Abyaneh/Control-of-Ball-Position-on-a-Horizontal-Rod/Report.pdf

### In the Name of God

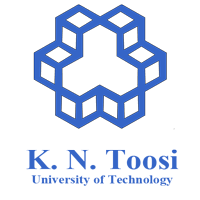
[picture p2: figure]

## Control of Ball Position on a Horizontal Rod

Table of Contents:

1. Introduction | 4
2. Modeling, Theoretical Review, and Dynamic Analysis | 5
3. Introduction of Components | 8
3.1 AC Servo Motor (Delta Asda A2) | 8
3.2 Servo Motor Driver (ASD-A2-0721-M) | 9
3.3 STM32 Microcontroller Board (F407ZET6) | 10
3.4 Planetary Gearbox (C002F0420MT10) | 10
3.5 Ultrasonic Distance Sensor (SRF05) | 11
3.6 Encoder | 12
3.7Interface Board | 12
3.8 Power Supply and Fuse | 13
3.9 Voltage Regulator (Lm2596) | 14
3.10 ST-LINK/V2 Programmer | 14
3.11 Magnetic Limit Switches | 15
3.12 Final Assembly of the System | 15
4. System Specifications | 16
5. STM32 Pin Descriptions | 16
5.1 Important Pin Functions (TRIG, ECHO, Pulse, Direction,
USART) | 16
5.2 General Configuration of Pins | 18
6. STM32 Code Logic | 19
6.1 Library Initialization | 19
6.2 Sensor and Motor Control Setup | 19
6.3 PID Controller Setup | 20
6.4 Loop Structure and Sensor Feedback | 20
6.5 While Loop and Motor Control | 20
6.6 Ultrasonic Sensor Data Reading | 21
7. MATLAB Code | 22

### 1. Introduction:

One of the most fascinating and relatively simple examples of mechanical engineering and control systems is the ball and rod system. The overall function of this system is to control and maintain a ball on a horizontal rod, which is connected to a motor and specific supports. The system should be able to keep the ball in position, even if an external disturbance affects the ball.

The position of the ball is determined by sensors, which will be explained in more detail later. Using these sensors, the motor generates the necessary torque to rotate the rod and maintain the ball's balance. Any potential errors detected by the sensors are sent to the controller, which then sends appropriate commands to the motor.

### 2. Modeling, Theoretical Review, and Dynamic Analysis:

The ball and rod system can be examined in two main configurations:

1. The motor is positioned at the center of the rod.
2. The motor is located at the end of the rod and connected by a lever.

A schematic of these two types is shown in Figure 1.

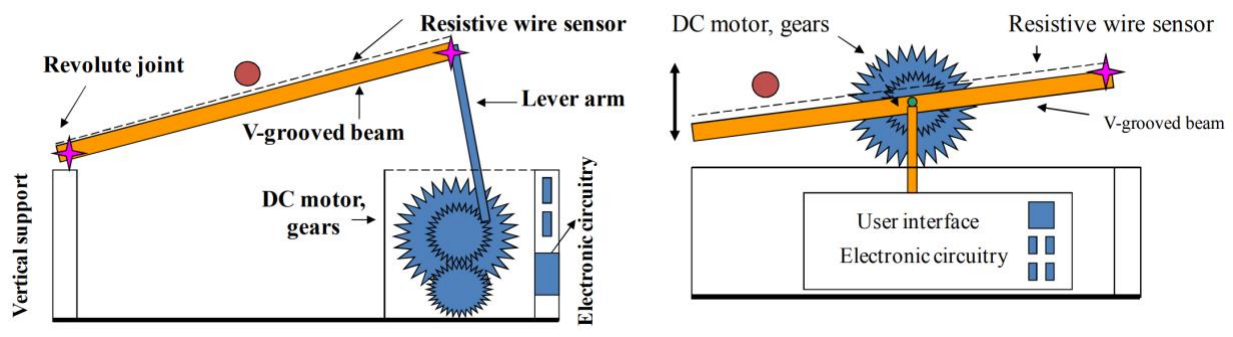
[picture p3: figure]

Our project is based on the right-side configuration, where the motor is located at the center of the rod. This system can be solved using both Newtonian and Lagrangian methods (related to energy). For the Newtonian method, we first draw a free-body diagram for the system as shown in Figure 2.

A schematic of these two types is shown in Figure 1.

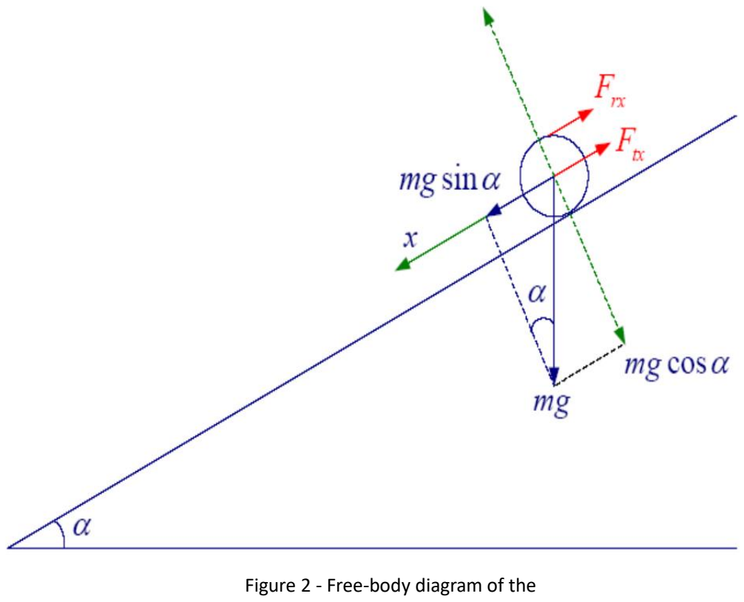
[picture p4: figure]
Figure 2 - Free-body diagram of the

The forces created by translational motion along the rod and the acceleration generated in this direction are represented by Ftx, and the forces created by rotational motion are represented by Frx. This rotational force itself creates a twisting torque around the ball, which is calculated by multiplying Frx by the radius of the ball. Additionally, we know that the sum of the torques is equal to the moment of inertia of the object times the angular acceleration.

The result of all these forces and torques can be expressed by the following equations:

Ftx = mẍ

Tr = FrxR = Jω̇

ω =

v
R

→ Tr =

J
R

ẍ → Frx =

J
R²

ẍ

In these equations:

- m is the mass of the ball,
- J is the moment of inertia of the ball,
- x is the position of the ball on the rod,
- TrTr is the rotational torque of the ball,
- R is the radius of the ball.

Furthermore, the sum of the forces can be expressed as:

Frx + Ftx = mg sin α

Next, using the energy method, we know that the total energy of the system is the sum of the energy of the rod and the ball:

T = Tbeam + Tcylinder

Tbeam =

1
2

Ibθ̇
b

2

For the ball, which is modeled as a cylinder, the kinetic energy is given by:

Tcylinder =

1
2

mcṙc

2 +

1
2

Icθ̇
c

2

Ic =

1
2

mcR

2

where rc is the position of the ball on the rod and R is the radius of the circular cross-section of the cylindrical ball.
ṙc = Rθ̇
c
Therefore, the total kinetic energy of the system can be expressed as follows:

T =

1
2

Ibθ̇
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
Ibθ̇
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
Ibθ̇
b

2 +

3
4

mcṙc

2

Now, provided that the angle the rod makes with the horizontal is θb, we will also have for the potential energy of the system:
U = mcg. (rc sin θb)

It should be noted that the reference point for potential energy is the horizontal line passing through the center of mass of the rod, or the point of attachment of the motor, and for this reason, the potential energy of the rod remains unchanged, and the equation only includes the term related to the ball.

Now, we will derive the expression for the Lagrangian, which is the result of the difference between kinetic and potential energy:

L =

1
2

Ibθ̇
b

2 +

3
4

mcṙc

2 − mcg. (rc sin θb)

L(q, q̇) = T(q, q̇) − U(q) d
dt[

∂L
∂q̇
i

] −

∂L
∂qi

= Fqi

Now, in this system, we have two types of motion and consequently two generalized coordinates, which are θb and rc. Instead of Fqi, we will have the torque generated by the motor, which we denote as τ:
∂L
∂θb

= −mcgrc cos θb

∂L
∂rc

=

3
2

mcṙc

∂L
∂θ̇
b

= Ibθ̇
b →

d

dt[
∂L
∂θ̇
b

] = Ibθ̈
b

∂L
∂ṙc

=

3
2

mcṙc →

d
dt [

∂L
∂ṙc

] =

3
2

mcr̈c

On the other hand, the equations with respect to θb correspond to the torque of the system, and with respect to rc relate to the resultant force applied, which will result in:

Ibθ̈
b + mcgrc cos θb = τ
3
2

mcr̈c −

3
2

mcṙc = 0

Now, we can find the transfer function using one of the two methods discussed above. For example, based on the derived equation, we can take the Laplace transform, and if we set the initial conditions to zero, we will have:
J
R²

s

2X(s) + ms

2X(s) = mg. α(s)

G(s) =

X(s)
α(s)

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
For this system, we will have g=9.81 .m
s

2

, m=50.7 g, R=2 cm, and
J=0.5 mR²
, which results in the value of the transfer function being equal to:
J = 1.014 ∗ 10⁻⁵

[kg. m²
]

G(s) =

6.54
s

2

[

m
rad]

It should be noted that the angle of the rod is considered as the input, and the position of the ball is considered as the output.

### 3. Introduction of Components:

### 3.1 AC Servo Motor, Model Delta Asda A2:

- This model of servo motor is used as the system’s driving force.
- Inputs: VAC110 and 5.1A, Output: 0.75KW
- Maximum Output Speed: 3000rpm, Maximum Torque: 2.39N.m

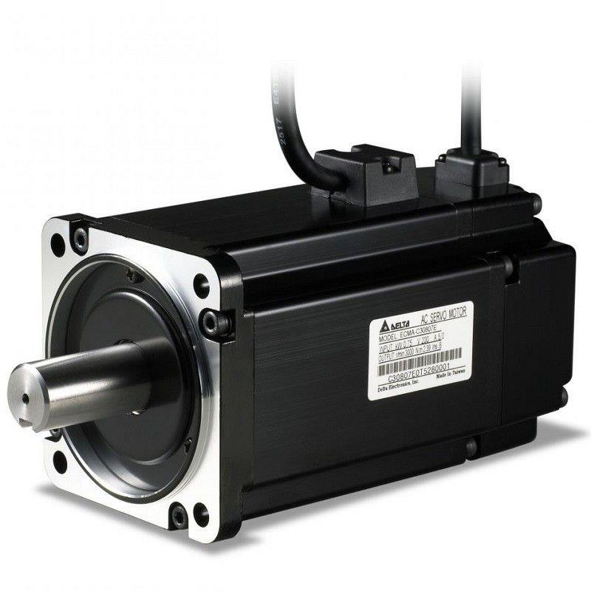
[picture p5: figure]

Figure 3 - AC Servo Motor, Model Delta Asda A2

### 3.2 Servo Motor Driver, ASD-A2-0721-M:

- The STM32 board sends commands to the driver, which adjusts the motor's position and applies the correct voltage.
- Input: 200-230V, Output: 110V, 5.1A

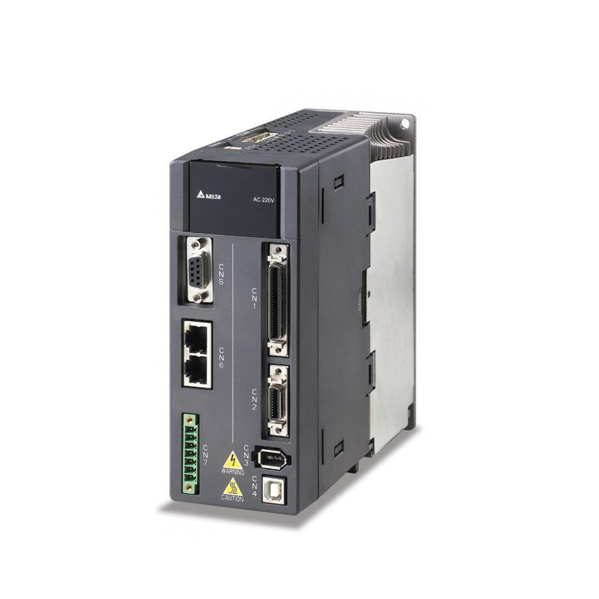
[picture p6: figure]

Figure 4 - Servo Motor Driver, ASD-A2-0721-M

### 3.3 STM32 Board, Model F407ZET6:

- This board controls the system and sends signals to the motor driver to adjust the motor’s position.

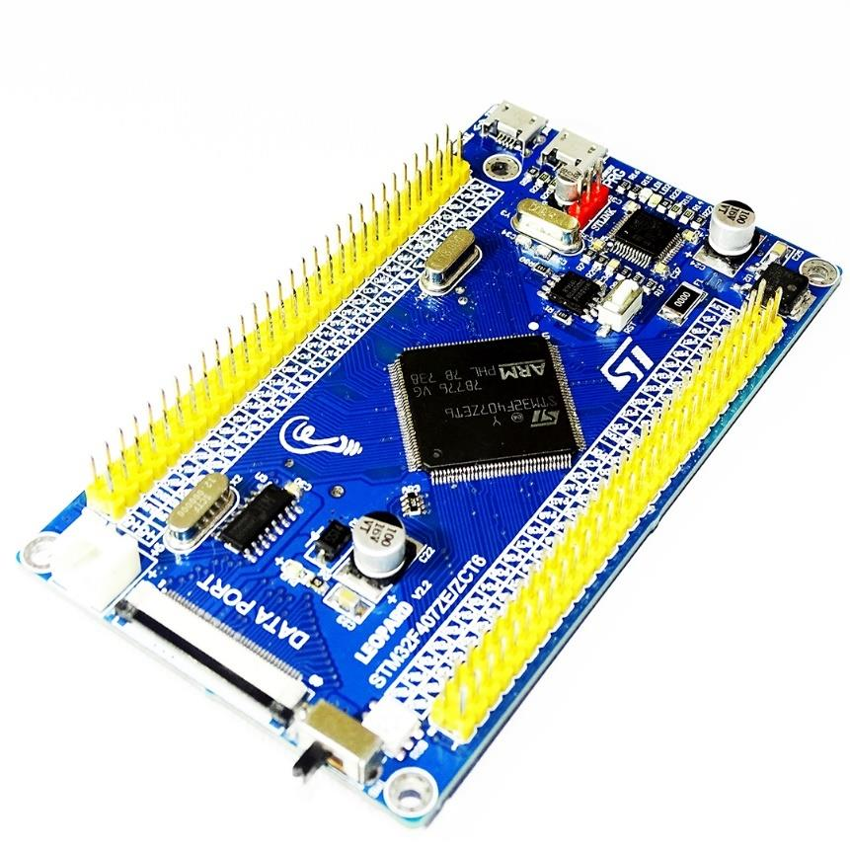
[picture p7: figure]

Figure 5 - STM32 Board, Model F407ZET6

3.4Planetary Gearbox, Model C002F0420MT10:

- This planetary gearbox is connected to the motor and has a gear ratio of 41.8:1, meaning the motor must rotate 41.8 times for the rod to rotate once.

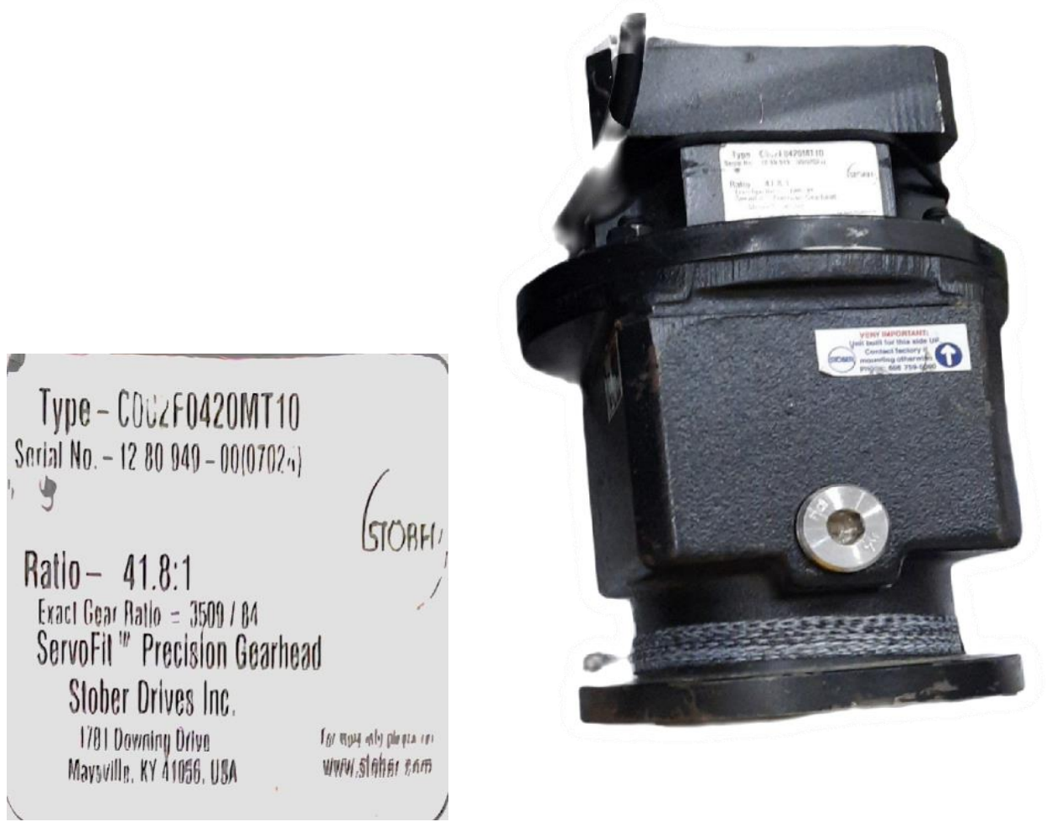
[picture p8: figure]

Figure 6 - Planetary Gearbox, Model C002F0420MT10

### 3.5 Ultrasonic Distance Sensor Model SRF05:

The SRF05 ultrasonic distance sensor module is used for measuring distances and is capable of measuring distances from 2 centimeters to 450 centimeters with an accuracy of 3 millimeters. Other specifications are as follows: Operating voltage: 4.5 to 5.5 volts DC, Current: 10 to 40 milliamps, Operating temperature: 0 to 70 degrees Celsius.

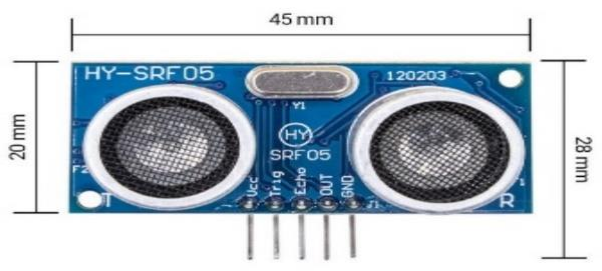
[picture p9: figure]

Figure 7 – Ultrasonic Distance Sensor Model SRF05

### 3.6 Encoder:

In general, an encoder is a device or process that converts data from one format to another. In a position sensor, this device can identify and convert mechanical movement into an analog or digital coded output signal and is located at the back of the motor attached to it. (Specifications: Encoder type: Incremental, 17 bits, and pulses per revolution: ppr160000)

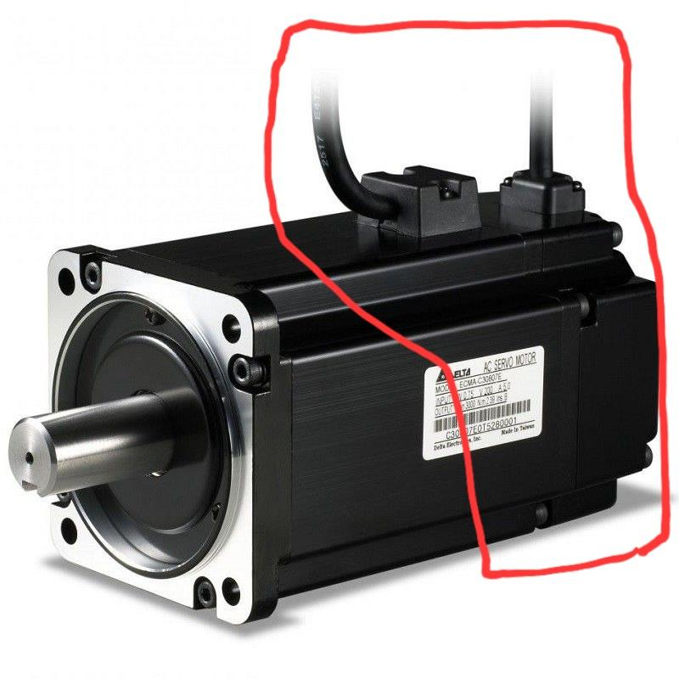
[picture p10: figure]

Figure 8 – Encoder

### 3.7 Interface Board:

The CN1 socket conversion board for the motor driver is used to connect the control wires to the driver.

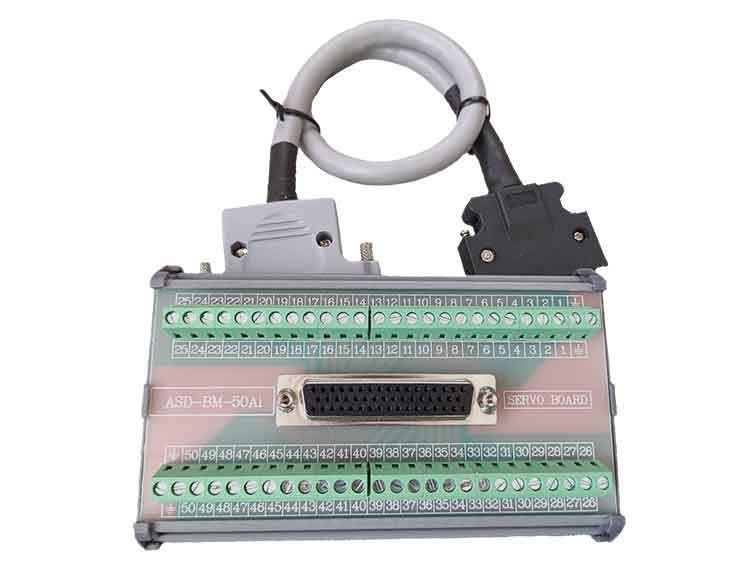
[picture p11: figure]

Figure 9 – Interface Board

### 3.8 Power Supply with Delta Brand and Fuse:

The power supply used is 24 volts and 2.5 amps with the Delta brand. Additionally, a 16-amp fuse is placed alongside it to protect the device against unauthorized electrical currents.

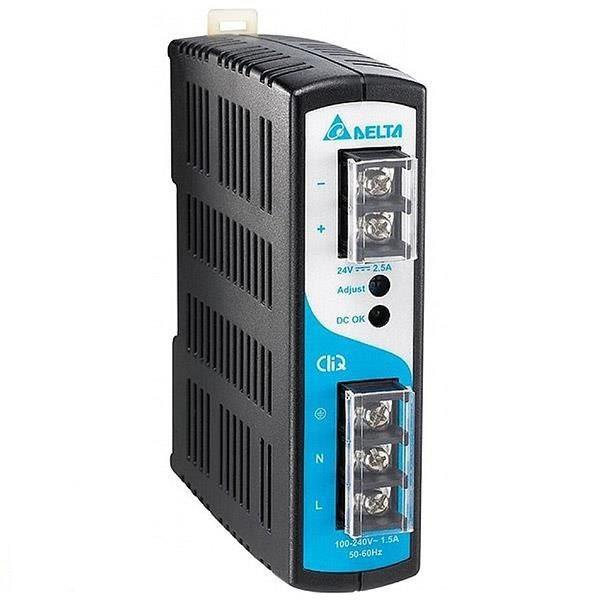
[picture p12: figure]
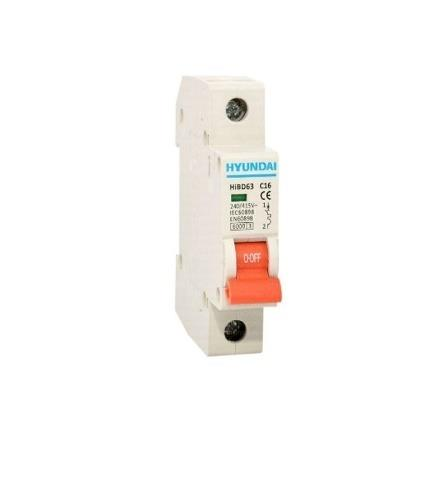
[picture p13: figure]

Figure 10 – Power Supply with Delta Brand and 16-Amp Fuse

### 3.9 Module with Model LM2596:

In this device, we have used a module that is connected to the 24-volt power supply. Its function is to take 24 volts from the power supply and convert it to 5 volts (it is a voltage step-down module). This 5 volts is then transferred to the STM32 board and the ultrasonic sensors.

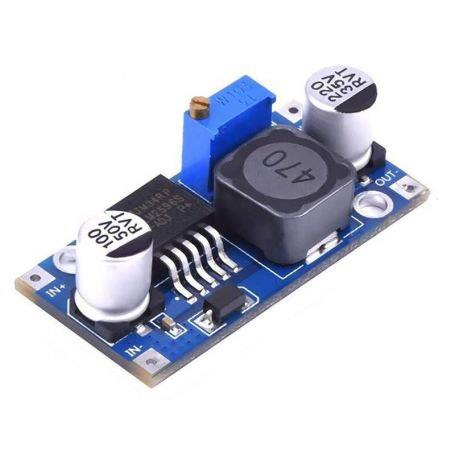
[picture p14: figure]

Figure 11 – Module with Model LM2596

### 3.10 ST-LINK/V2/01-0 Programmer:

The programmer connects to one side to the laptop and the other side to the STM32, transferring information from the laptop to the STM32.

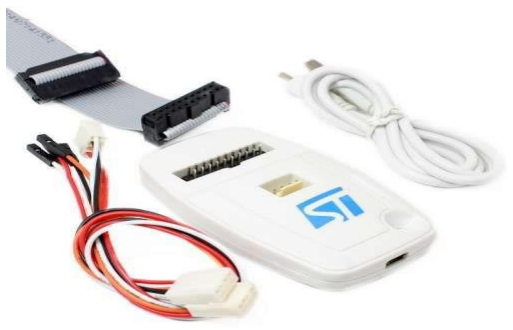
[picture p15: figure]

Figure 12 – ST-LINK/V2/01-0 Programmer

### 3.11 Magnetic Limit Switch:

The magnetic limit switch is used to prevent excessive rotation of the arm and damage to the system. This limit switch is installed on both sides of the arm and does not allow the arm to rotate beyond positive and negative 45 degrees.

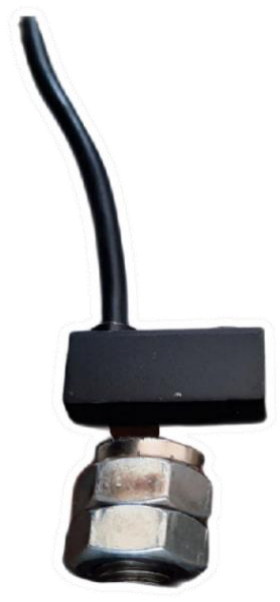
[picture p16: figure]

Figure 13 – Magnetic Limit Switch

### 3.12 Final Assembled Device:

After connecting the components that were previously described, the final device, as shown below, is assembled .

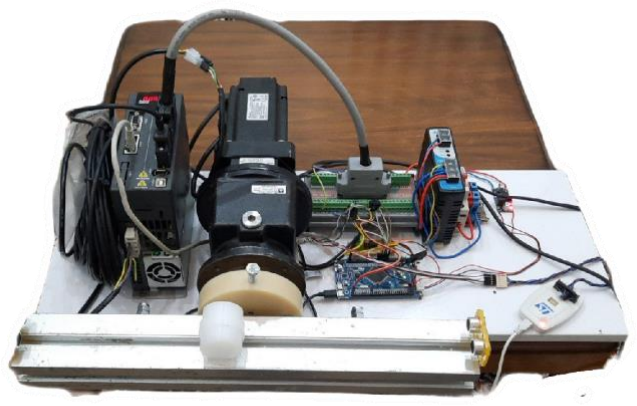
[picture p17: figure]

Figure 14 – Final Assembled Device

### 4. Other Specifications of the Assembled System Components:

Other specifications include the mass of the cylindrical ball used, which is 50.7 grams, and the diameter of the ball is 4 centimeters; additionally, the length of the rod is 45 centimeters.

### 5. Explanation of Several STM32 Pins:

In the figure below, you can see an overview of the STM32 IC, where we have identified the input and output pins (it has a total of 144 pins). We will later elaborate on its important pins.

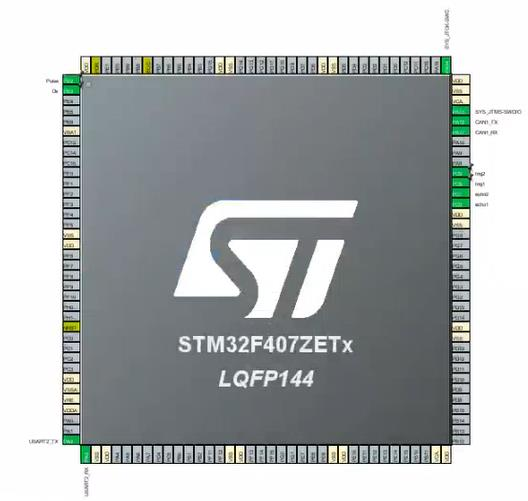
[picture p18: figure]

Figure 15 – Overview of the STM32 IC

### 5.1 Explanation of Important Pins :

As shown in the overview of the STM32, there are several yellow pins referred to as power pins, which are used to keep the STM32 powered on. Additionally, these pins cannot be defined as input or output .

In the figure, there are also green pins, which are defined as input and output pins.

•As shown in the figure below, the trig and echo pins are indicated, which are for the ultrasonic sensor. Symbol 1 represents Sensor 1, and symbol 2 represents Sensor 2. (The ultrasonic sensor receives a command from trig and sends the result through echo, allowing it to measure distance.)

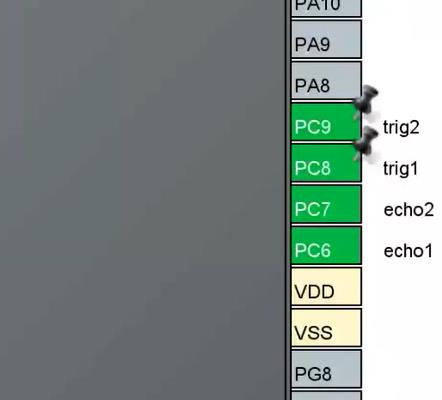
[picture p19: figure]

Figure 16 – Trig and Echo Pins
- As shown in the figure below, the pulse and Dir pins are indicated, to which the motor is connected. (Direction is used to change the motor’s direction, and Pulse is the signal that controls distance and speed.)

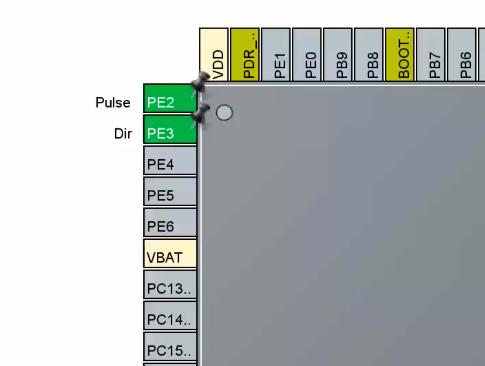
[picture p20: figure]

Figure 17 – Pulse and Direction Pins

- As shown in the figure below, the USART2_TX and USART2_RX pins are indicated, which are used to send data to the computer.

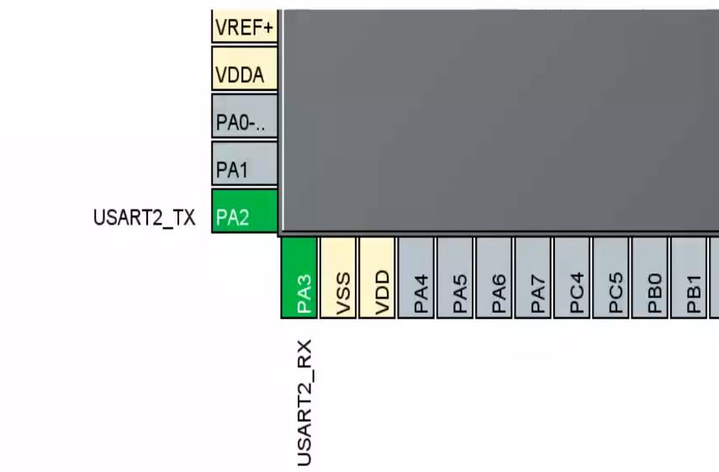
[picture p21: figure]

Figure 18 – USART2_TX and USART2_RX Pins

### 5.2 Brief Explanation of General Settings:

As shown in the figure below, settings such as data transmission speed, type, and more can be configured from this menu.

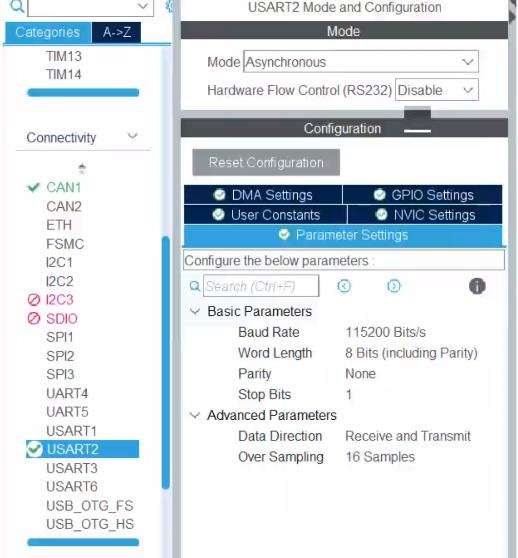
[picture p22: figure]

Figure 19 – General Settings

### 6. STM32 Code and Its Logic:

To analyze the code, we will divide it into different sections and then provide explanations regarding each section.

6.1

Figure 20

In this section, we have defined libraries; for example, lines 24, 25, and 26 are for converting text to numbers and vice versa. Line 27 includes the PID library, which takes parameters such as the k values and position, and then outputs the required value.
6.2

Figure 21
In lines 55, 56, and 57, we defined the initial values of the K parameters as type double. Line 58 is the PID output, line 59 is the target position we want to reach, and line 60 is the current position of the ball.

6.3

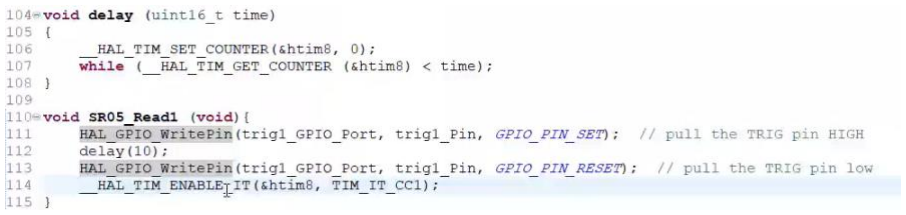
[picture p23: figure]

Figure 22
This code is for configuring the ultrasonic sensor, and GPIO refers to the pins we mentioned earlier. In this code, it is first turned on with the ‘set’ command, followed by a delay of 10 milliseconds, and then it is turned off. This instructs the ultrasonic sensor to send data.
6.4

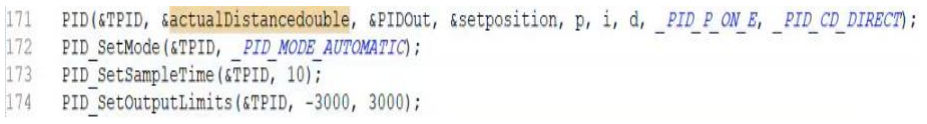
[picture p24: figure]

Figure 23
Line 171 defines the PID library (in which the variables P, I, and D, actualDistance, PIDout, and setposition are defined, and the PID variables are stored in PIDout). Line 174 indicates the minimum and maximum angle. It is noteworthy that since we could not input decimal numbers, we multiplied by 100, meaning that the angle range can be ±30 degrees (the last two digits are considered as decimals). When the information is sent to the motor, it is divided by 100.
6.5

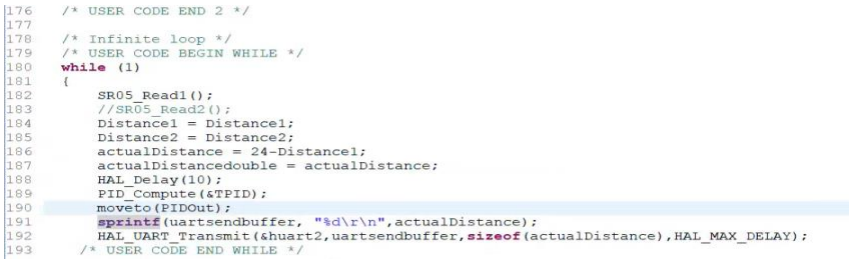
[picture p25: figure]

Figure 24

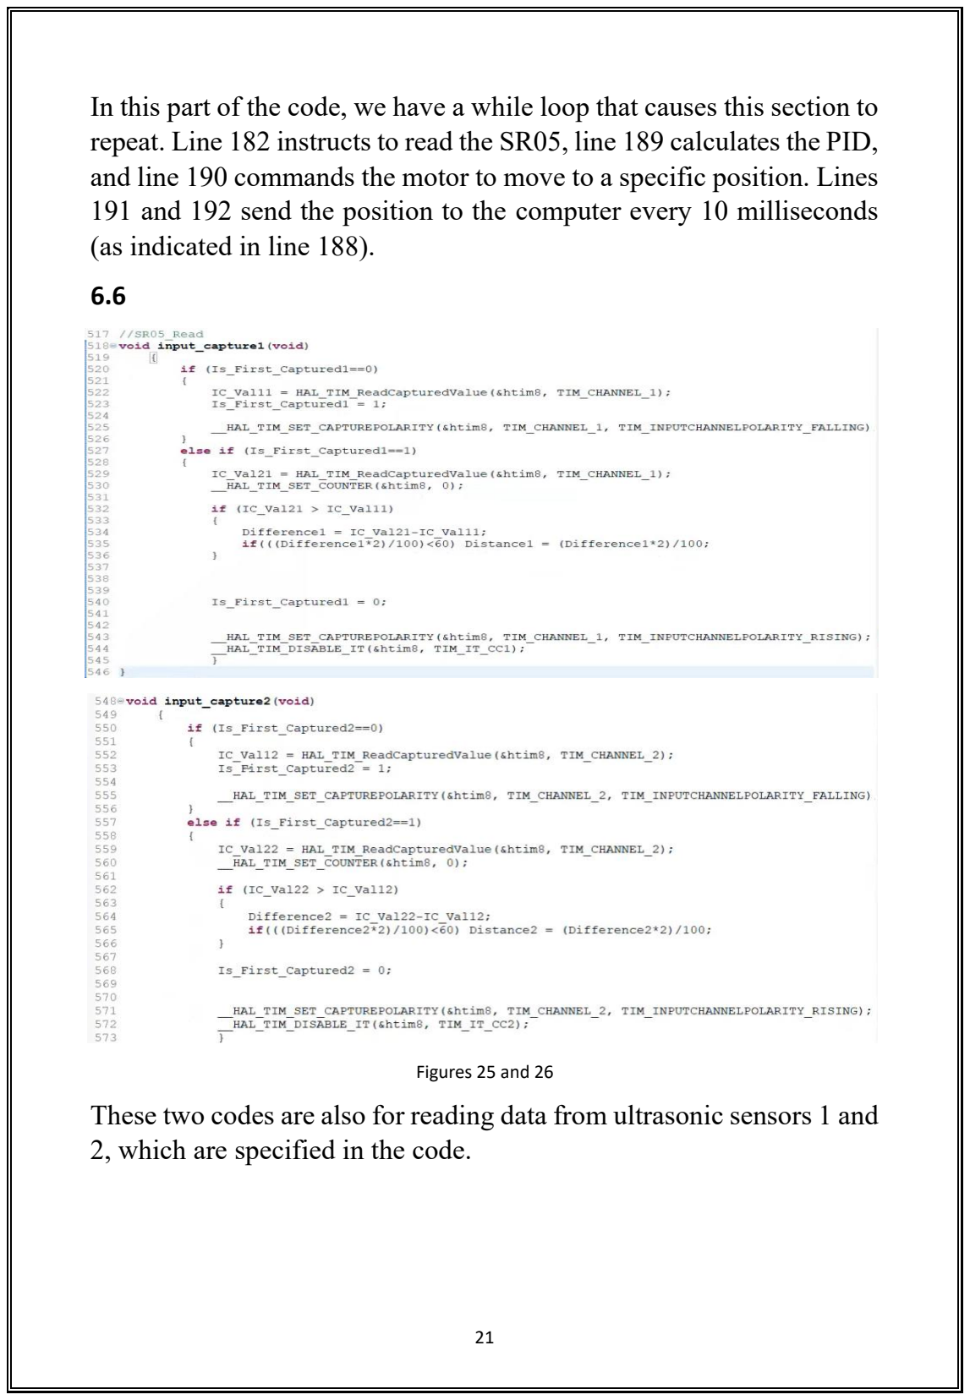
[picture p26: page 21]

In this part of the code, we have a while loop that causes this section to repeat. Line 182 instructs to read the SR05, line 189 calculates the PID, and line 190 commands the motor to move to a specific position. Lines 191 and 192 send the position to the computer every 10 milliseconds (as indicated in line 188).
6.6

Figures 25 and 26
These two codes are also for reading data from ultrasonic sensors 1 and 2, which are specified in the code.

### 7. MATLAB Codes for the Graph:

To draw the graph, we first receive the data from the computer using the C code written in the STM32 environment in a .txt format. The numbers in the first column correspond to the position of the ball, and the numbers in the second column represent the motor’s rotation angle
multiplied | by | 100. | This | multiplication | simulates | decimal
representation; it should be noted that the text files are also attached. We then transfer this data to Excel, and subsequently, MATLAB reads the Excel file, allowing us to create the desired variables. More detailed explanations are provided in the images below, which relate to the MATLAB software.

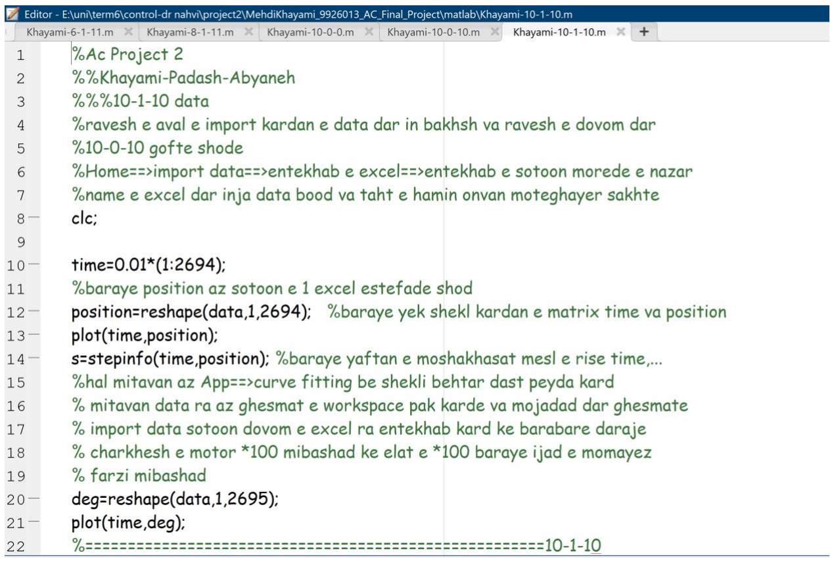
[picture p27: figure]

Figure 27 -MATLAB code: kp = 10, ki = 1, kd = 10

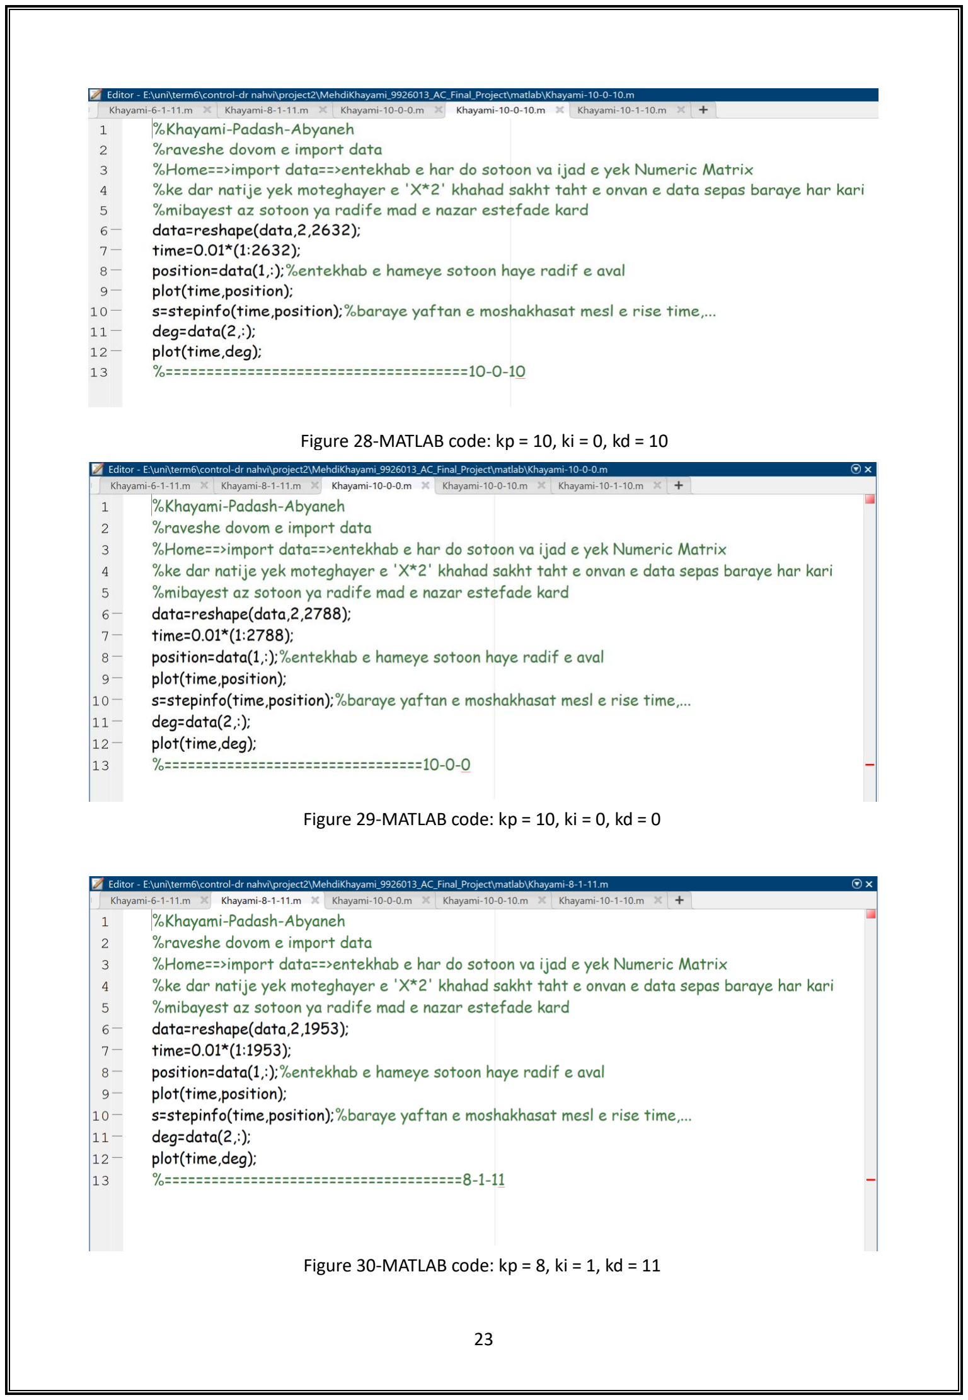
[picture p28: page 23]

Figure 28-MATLAB code: kp = 10, ki = 0, kd = 10

Figure 29-MATLAB code: kp = 10, ki = 0, kd = 0

Figure 30-MATLAB code: kp = 8, ki = 1, kd = 11

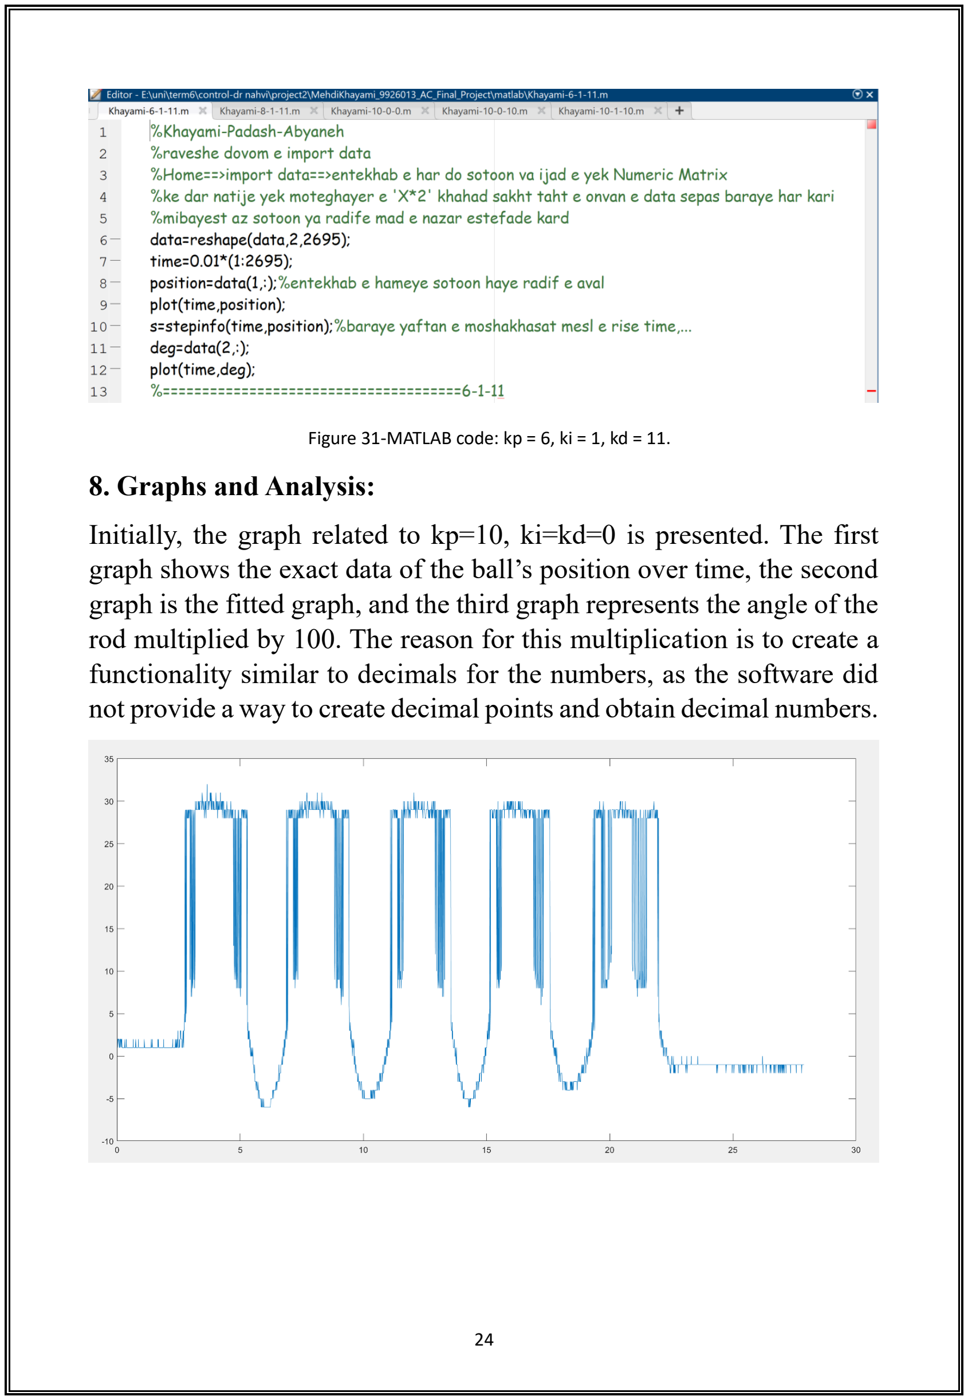
[picture p29: page 24]

### 8. Graphs and Analysis:

Initially, the graph related to kp=10, ki=kd=0 is presented. The first graph shows the exact data of the ball’s position over time, the second graph is the fitted graph, and the third graph represents the angle of the rod multiplied by 100. The reason for this multiplication is to create a functionality similar to decimals for the numbers, as the software did not provide a way to create decimal points and obtain decimal numbers.

Figure 31-MATLAB code: kp = 6, ki = 1, kd = 11.

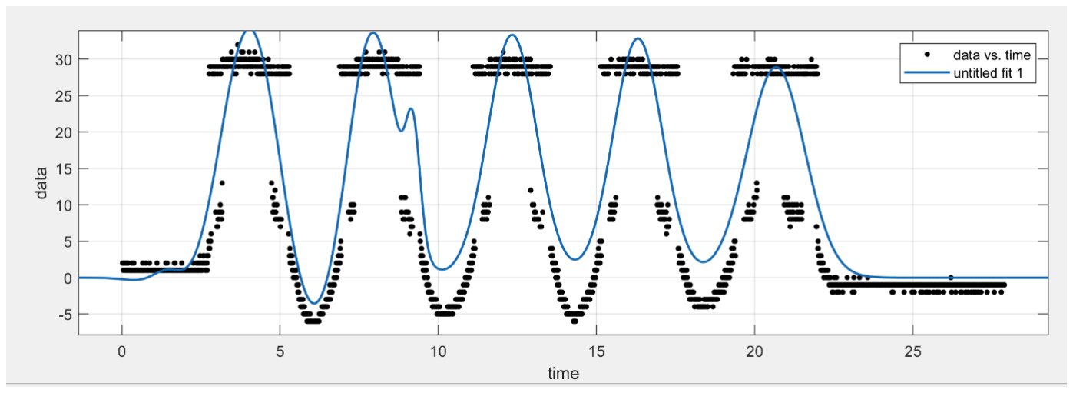
[picture p30: figure]
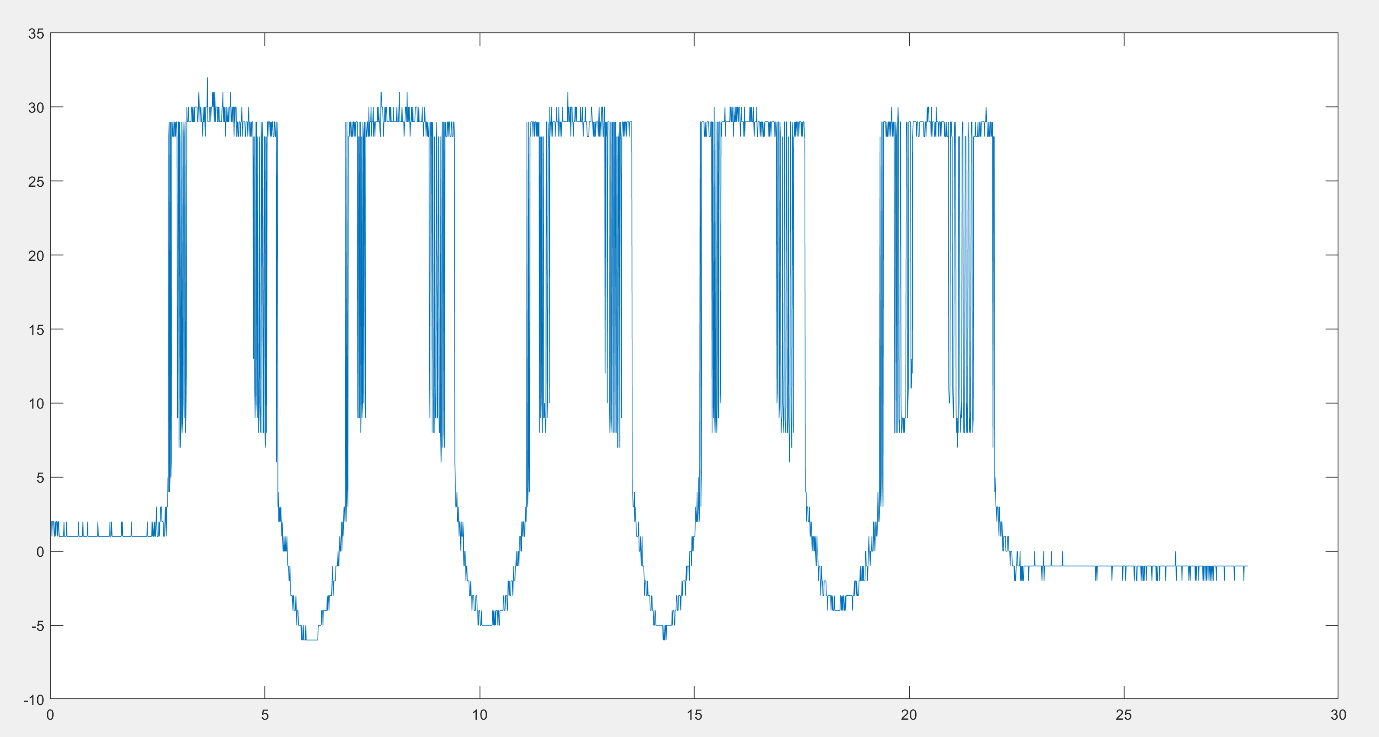
[picture p31: figure]

Figures 32,33 and 34- graph related to kp=10, ki=kd=0
As can be seen from the above figures, the graph starts from a positive value, which represents the ball’s position at the initial moments for observing and analyzing the system, and continues with significant fluctuations. This means that the system oscillates periodically, indicating that the controller is a proportional controller. It should be noted that even at the end of the time interval, the ball does not return to the desired position, which is zero.

In this system, the settling time is 23 seconds, the rise time is 5.4 seconds, the peak time is 3.6 seconds, and the peak value is 32 centimeters. The reason for the excessively high peak value is due to the low accuracy of the ultrasonic sensors and the issues arising from the ball getting too close to these sensors, causing temporary

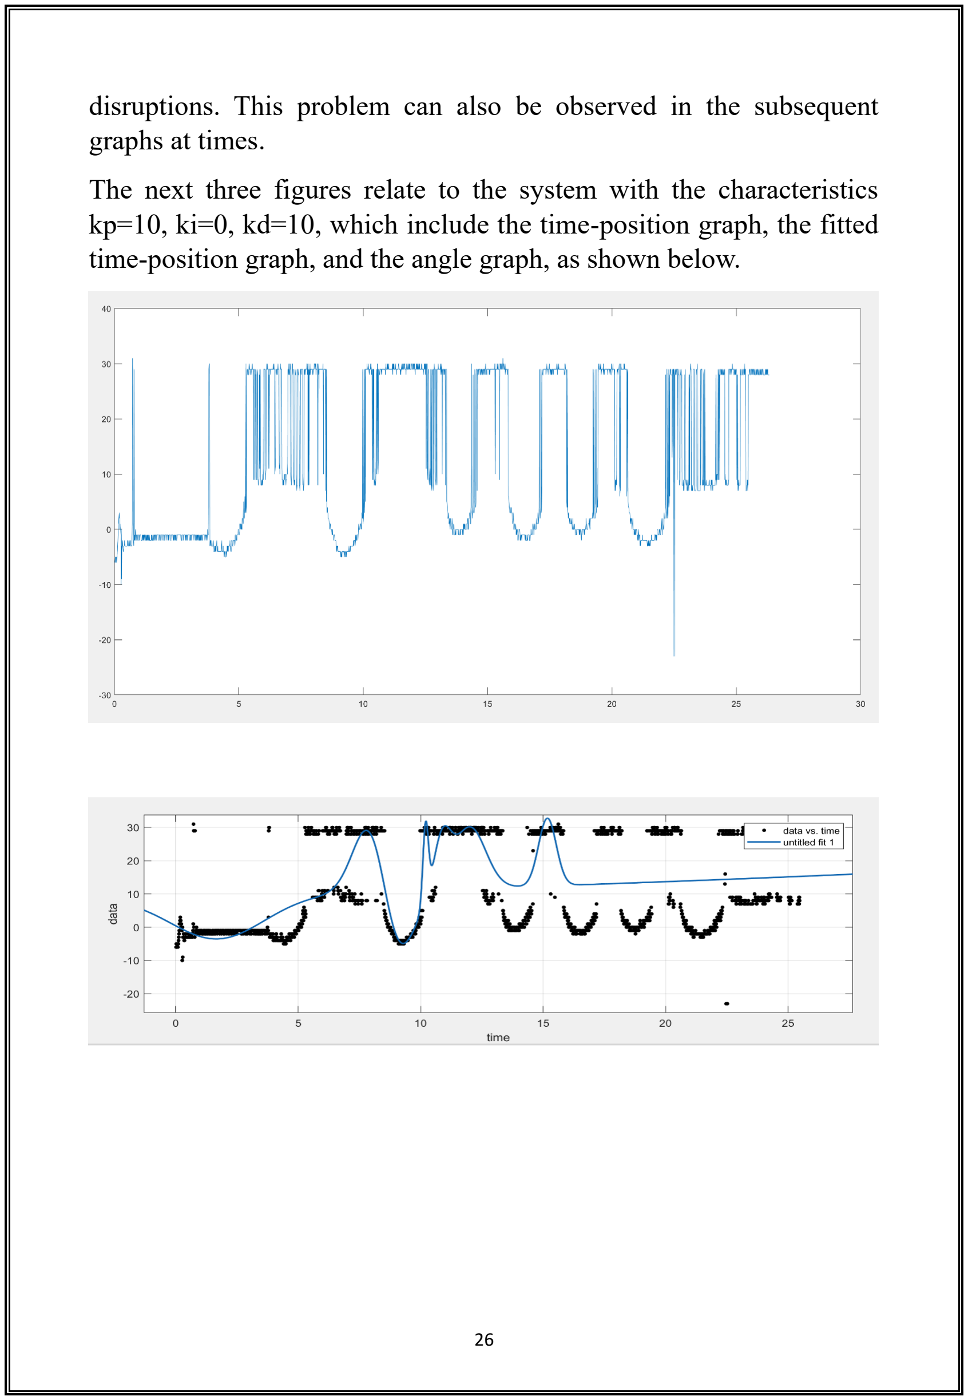
[picture p32: page 26]

disruptions. This problem can also be observed in the subsequent graphs at times.

The next three figures relate to the system with the characteristics kp=10, ki=0, kd=10, which include the time-position graph, the fitted time-position graph, and the angle graph, as shown below.

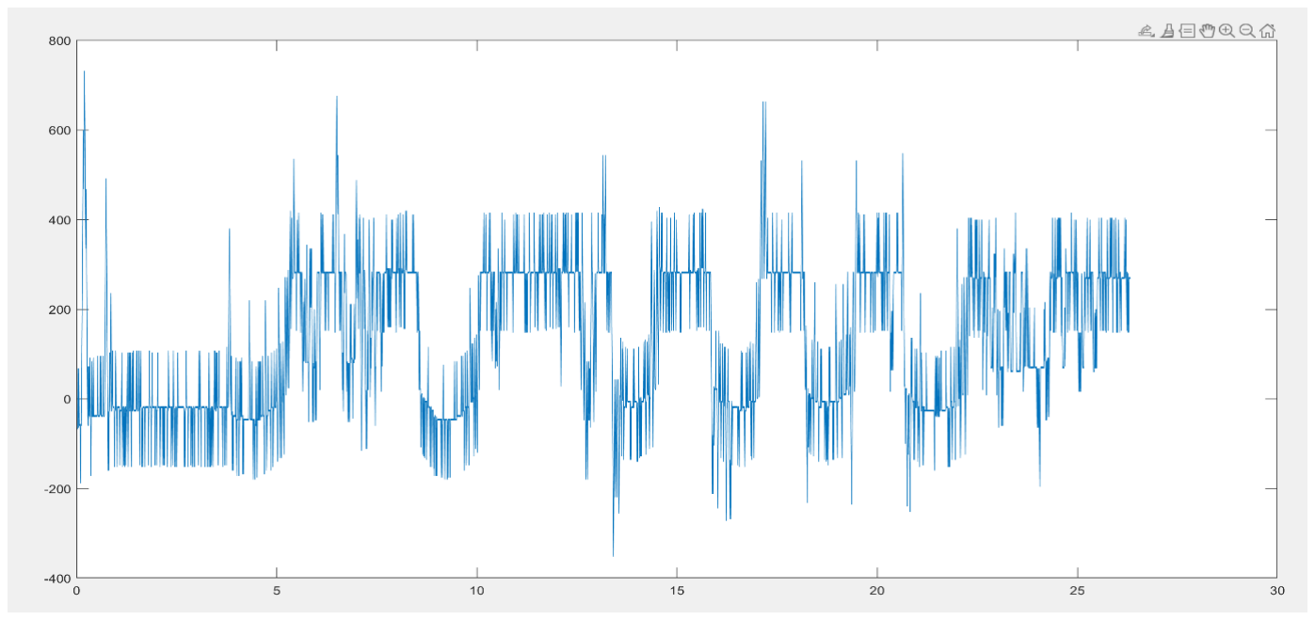
[picture p33: figure]

Figures 35,36 and 37- graph related to kp=10, ki=0, kd=10
With the addition of kd, we observe that in the graphs, the oscillation amplitude has decreased, and in fact, the response speed of the system has increased. This is due to the nature of this type of coefficient, which will be explained in more detail in the next section.

It is important to note that in this system, the settling time approaches infinity and is divergent. Additionally, the rise time is 0.1 seconds, the peak time is 15.7 seconds, and the peak value is 32 centimeters.

The next three graphs pertain to a system with the characteristics kp=10, ki=1, kd=10. As before, the first graph shows the exact data of the position over time, the second graph is the fitted version, and the third graph represents the angle.

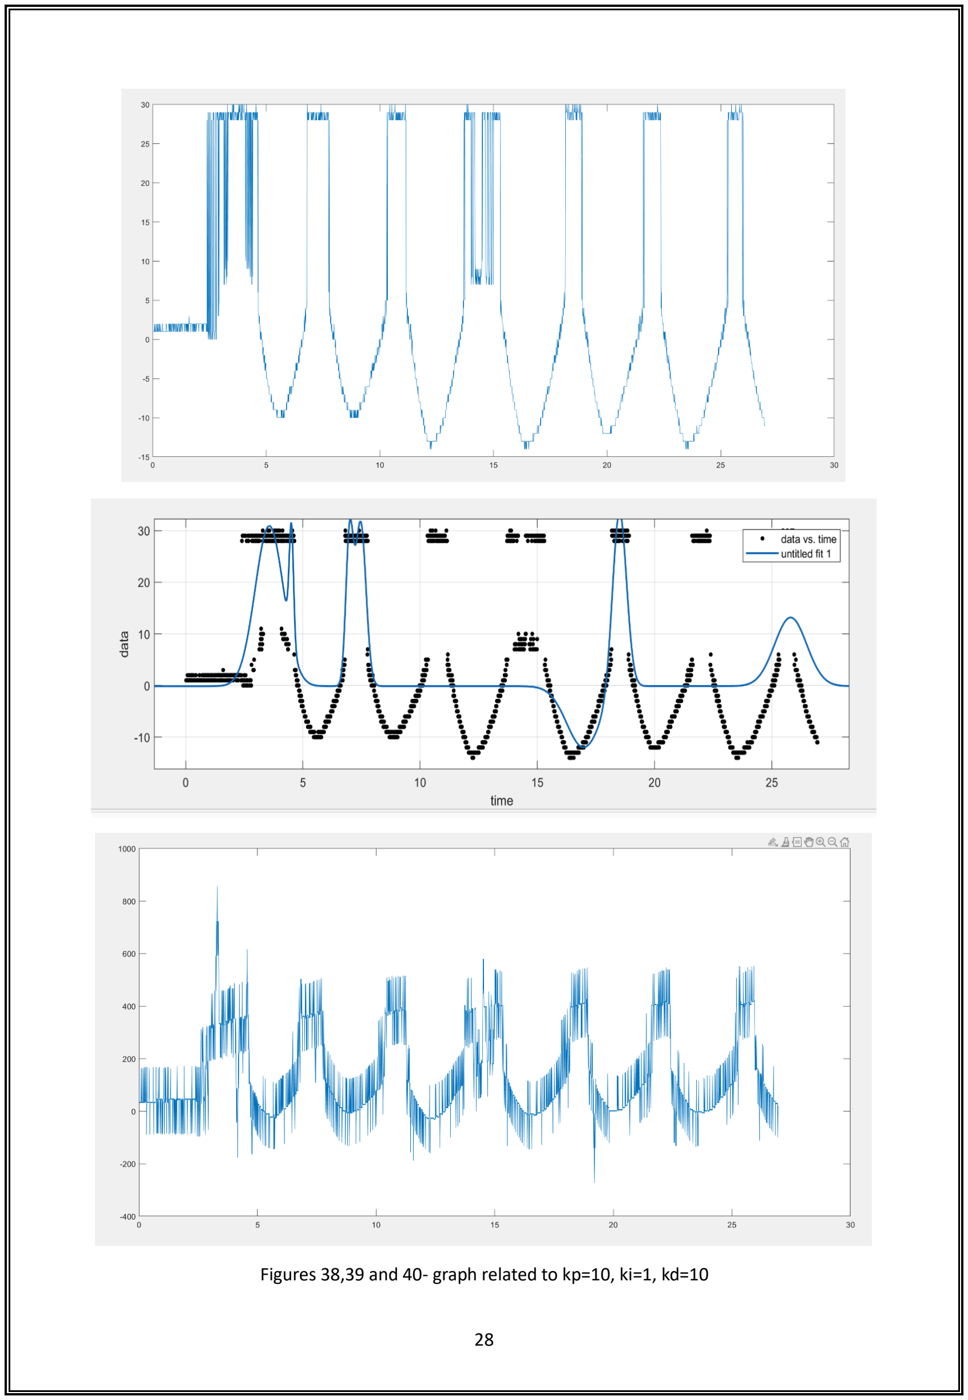
[picture p34: page 28]

Figures 38,39 and 40- graph related to kp=10, ki=1, kd=10

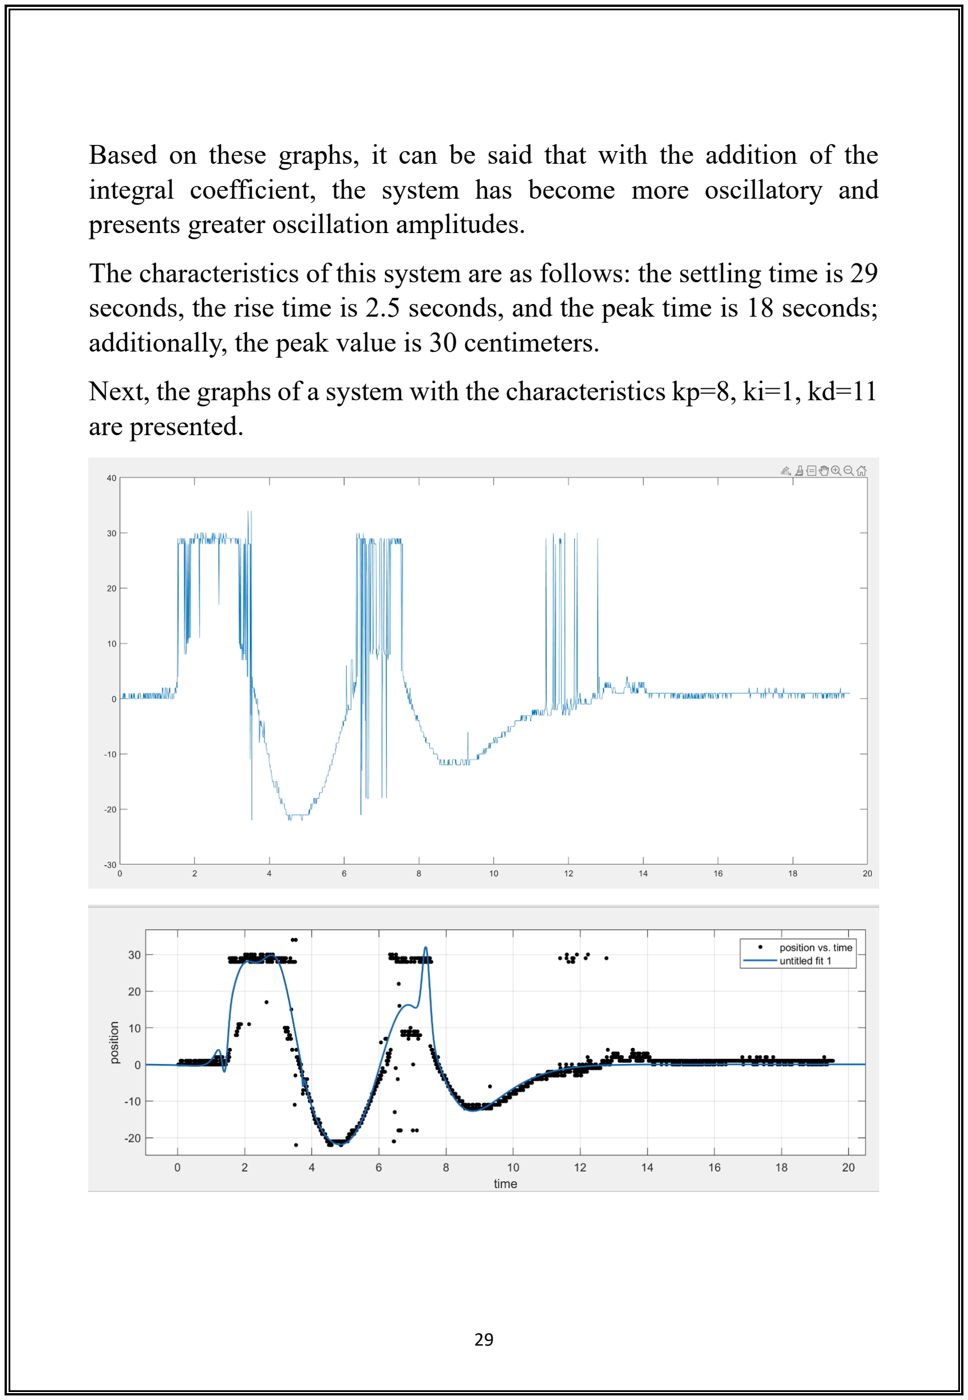
[picture p35: page 29]

Based on these graphs, it can be said that with the addition of the integral coefficient, the system has become more oscillatory and presents greater oscillation amplitudes.

The characteristics of this system are as follows: the settling time is 29 seconds, the rise time is 2.5 seconds, and the peak time is 18 seconds; additionally, the peak value is 30 centimeters.

Next, the graphs of a system with the characteristics kp=8, ki=1, kd=11 are presented.

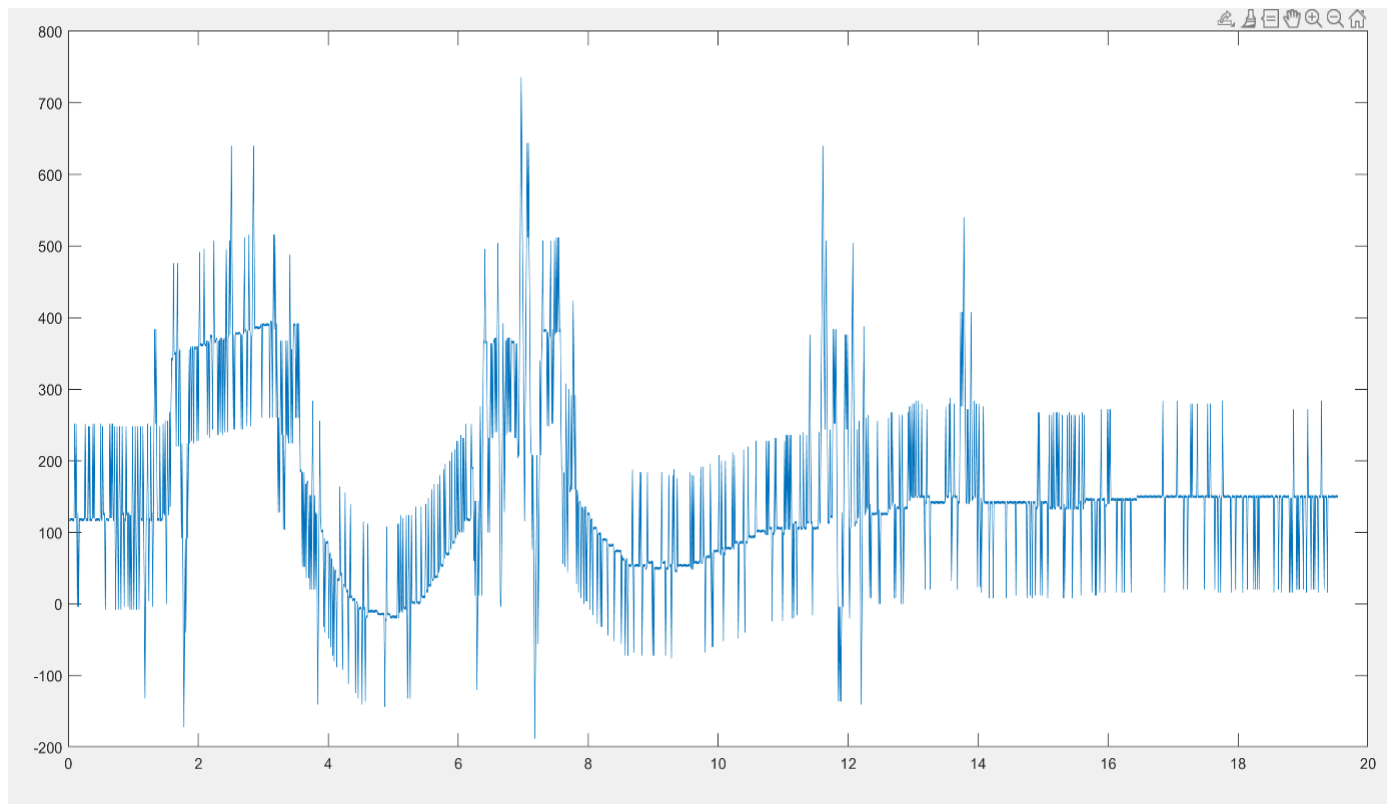
[picture p36: figure]

Figures 41,42 and 43- graph related to kp=8, ki=1, kd=11
The graphs clearly indicate that the system experiences fewer fluctuations and provides a better response to the input, ultimately approaching zero, which is our ideal position. We will see that this system performs better than the next system because it reaches the desired response more quickly and has a shorter settling time.

The characteristics of the mentioned system are as follows: the settling time is 13.95 seconds, the rise time is 3.6 seconds, the peak time is 3.7 seconds, and the peak value is 34 centimeters.

Finally, the graphs related to a system with the properties kp=6, ki=1, kd=11 are presented, which can be observed below.

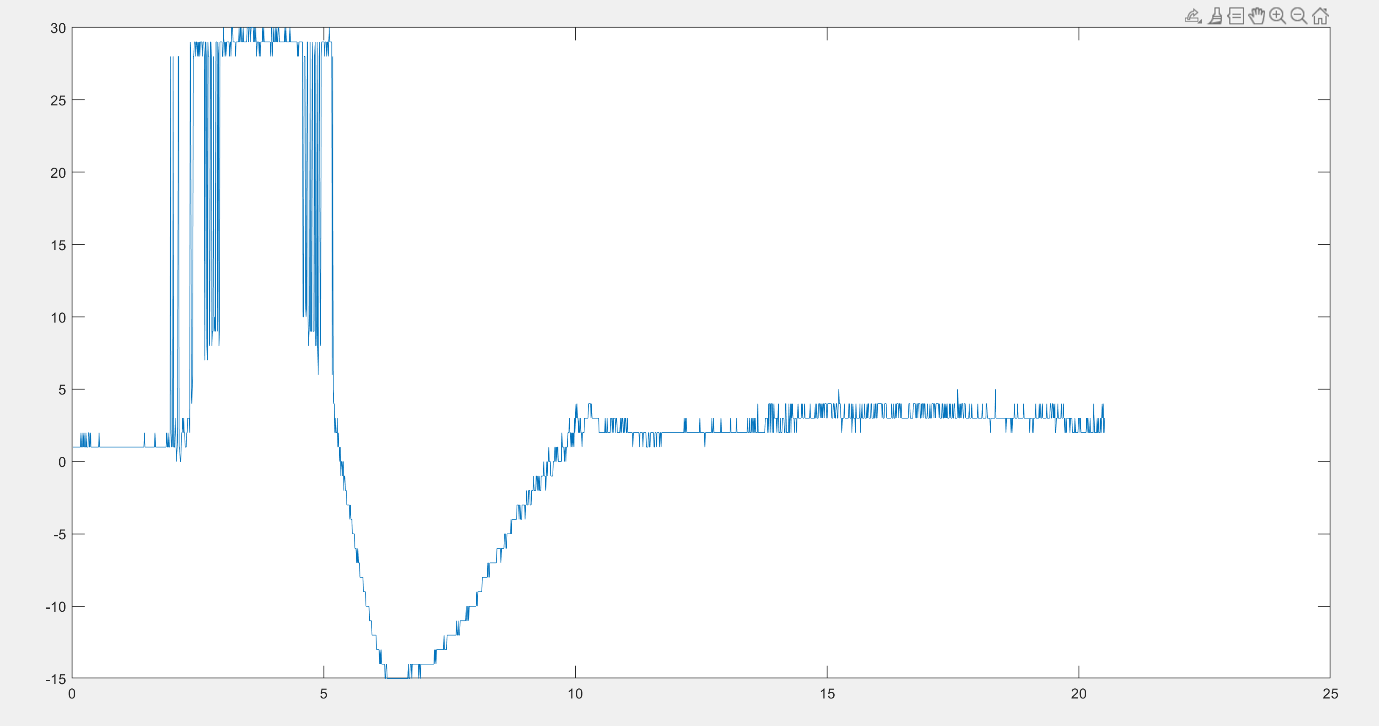
[picture p37: figure]

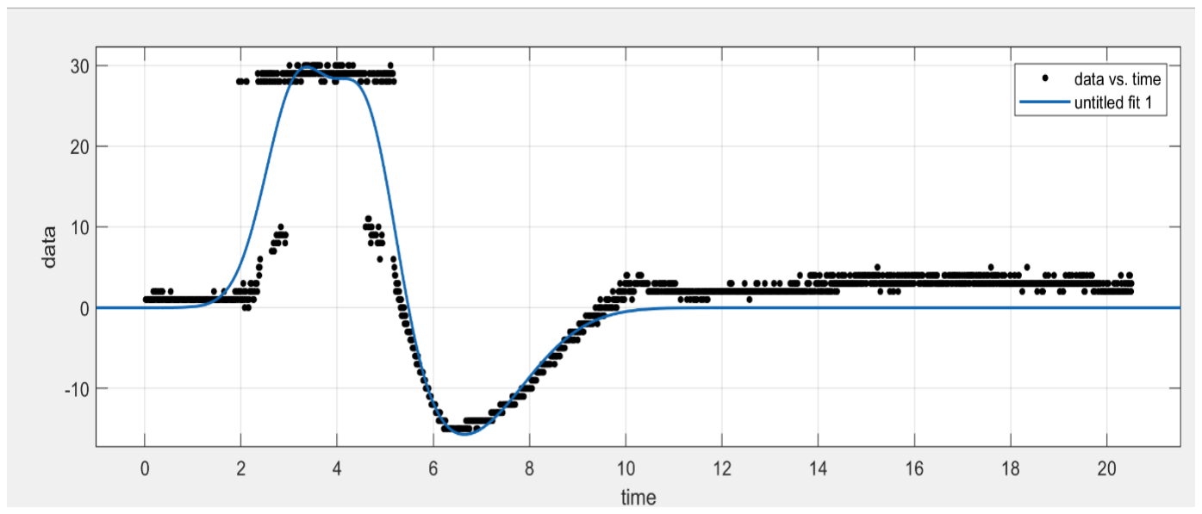
[picture p38: figure]
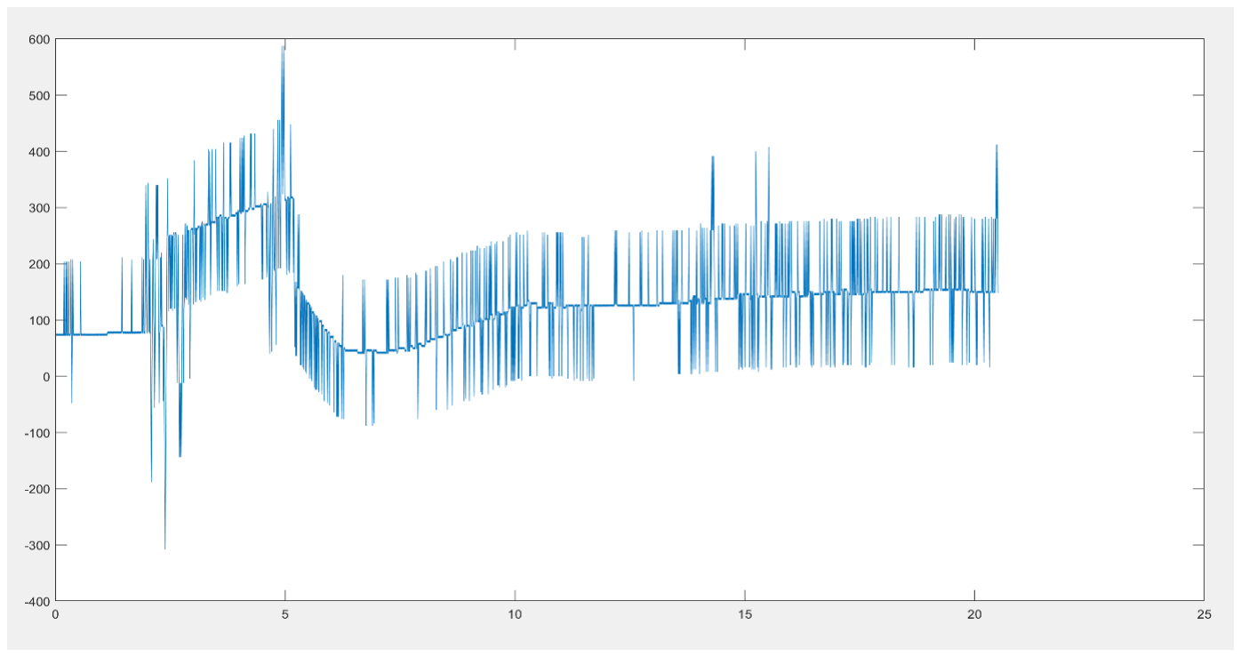
[picture p39: figure]

Figures 44,45 and 46- graph related to kp=6, ki=1, kd=11
Based on the graphs, it can be observed that the magnitude and amplitude of the oscillations have decreased, and the final value approaches the desired value, which is zero. However, it provides a slower response compared to the previously mentioned system.

The results obtained from this system are as follows: the settling time is 11.7 seconds, the rise time is 5.6 seconds, the peak time is 3.8 seconds, and the peak value is 32 centimeters.

### 9. Explanation of PID Coefficients:

A PID controller is a feedback controller that uses three parameters— P, I, and D—to convert a linear control input into a control output.

The parameters P, I, and D each have specific roles in controlling the system:

- (Proportional) P: This parameter determines how the control error (i.e., the difference between the desired and actual values) should influence the output at any moment. Increasing the value of P increases the control output and makes the response to the control error faster.
- (Integral) I: This parameter calculates the cumulative effect of the control error over time. Increasing the value of I improves the stability of the system.
- (Derivative) D: This parameter considers the rate of change of the control error. Increasing the value of D allows the controller to respond to changes more quickly and results in a response with less oscillation.

Based on the above explanations, the impact of each of the parameters P, I, and D on the control of the system in the PID controller regarding the angle of the pendulum is as follows:

- If the value of P is large, the control output responds more quickly to the controller signal, resulting in a faster response. However, if the value of P is too large, the control output will exhibit severe oscillatory responses, leading to increased instability.
- If the value of I is large, the control error is generally reduced, and the stability of the system improves. However, if the value of I is too large, the control output will also exhibit severe oscillatory responses, increasing instability.
- If the value of D is large, the controller responds more quickly to changes, and the response to the control error is accompanied by less oscillation. However, if the value of D is too large, the control output will again show severe oscillatory responses, leading to increased instability.

### 10. Scoring Section of This Project:

As we know, the goal of this project is to return the ball to its initial position, but we have expanded this part so that we can also define the position for the system. For this purpose, additional code has been added, such that for kp, we enter 8k, for changing ki we enter 1i, for kd we enter 11d, and for the desired position we type, for example, 2m (where m stands for position; note that the unit is in centimeters). Another way to change all these values in one line is to write 8k1i11d2m.

### 11. Group Members:

- Mehdi Khayami
- Mohammad Maleki Abyaneh
- Alireza Padash

### 12. References:

- https://en.wikipedia.org/wiki/Rise_time
- https://www.youtube.com/watch?v=ARewp6SCwGs
- https://www.youtube.com/watch?v=a_DW7xznPco
- https://ch.mathworks.com/help/simulink/slref/step.html
- https://ch.mathworks.com/help/control/ug/design-a-pid-controller-using-simulated-i-o-data.html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,Controller %20block%20from%20the%20model (https://ch.mathworks.com/help/control/ug/design-a-pid-controller-using-simulated-i-o-data.html) .
- https://ch.mathworks.com/help/ident/ref/dynamicsystem.stepinfo.html;jsessionid=6b28e793e5065351890a41478d7c (https://ch.mathworks.com/help/ident/ref/dynamicsystem.stepinfo.html;jsessionid=6b28e793e5065351890a41478d7c)
- https://www.youtube.com/results?search_query=overshoot+in+ matlab (https://www.youtube.com/results?search_query=overshoot+in+matlab)
- https://ch.mathworks.com/help/curvefit/curve-fitting.html
