Abyaneh/Control-of-Ball-Position-on-a-Horizontal-Rod/photos from project/group_image .png

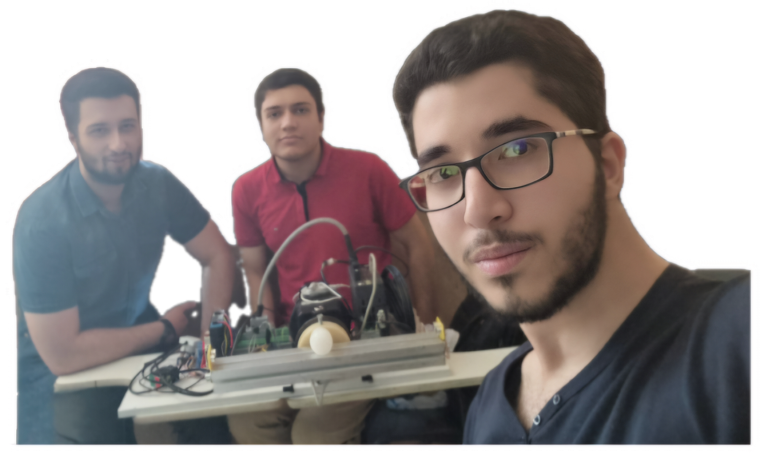
photos from project/group_image .png
