Abyaneh/Control-of-Ball-Position-on-a-Horizontal-Rod/plots/8-1-11-position-2.PNG

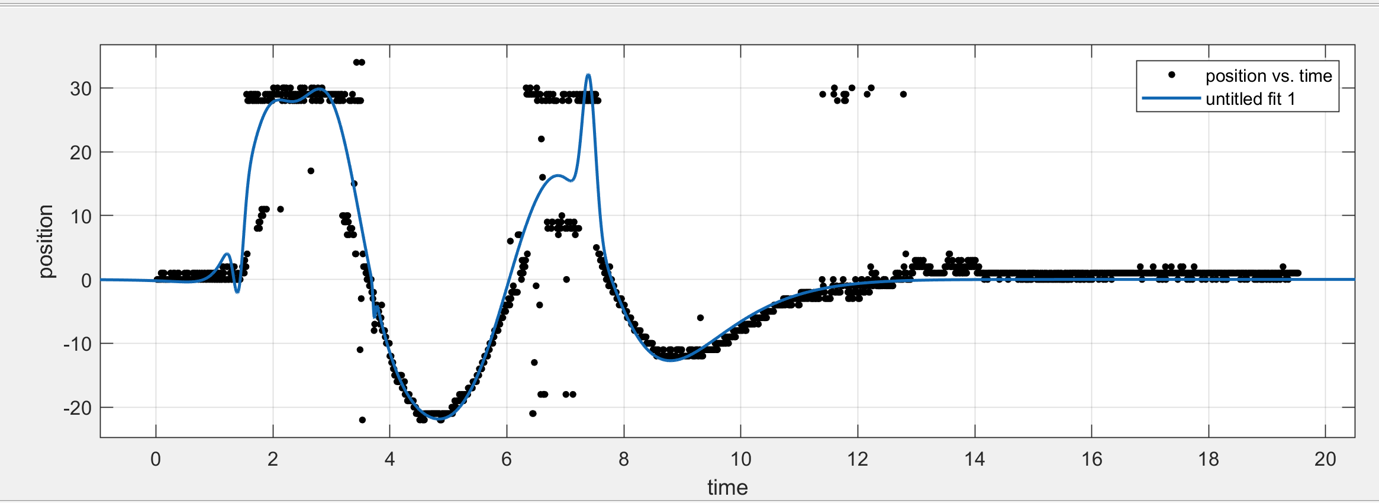
plots/8-1-11-position-2.PNG
