Abyaneh/Control-of-Ball-Position-on-a-Horizontal-Rod/plots/10-0-0-deg-1.PNG

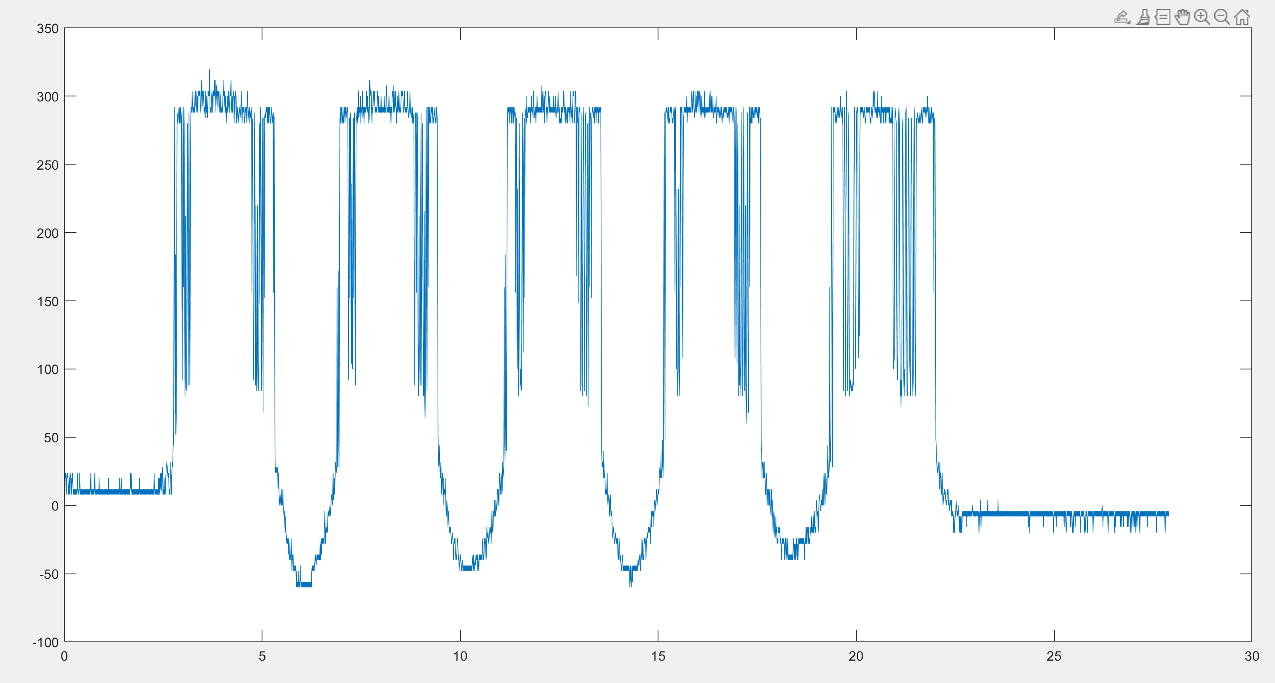
plots/10-0-0-deg-1.PNG
