Abyaneh/Control-of-Ball-Position-on-a-Horizontal-Rod/plots/10-0-10-position-2.PNG

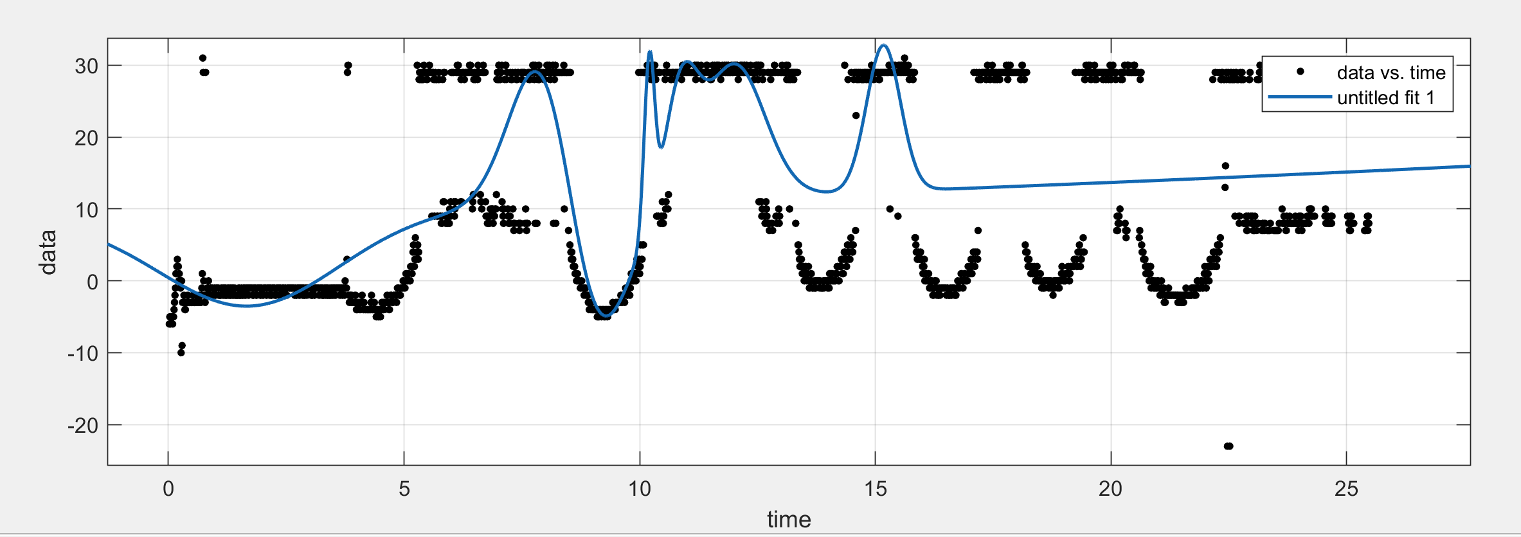
plots/10-0-10-position-2.PNG
