Abyaneh/Control-of-Ball-Position-on-a-Horizontal-Rod/plots/10-1-10-deg.PNG

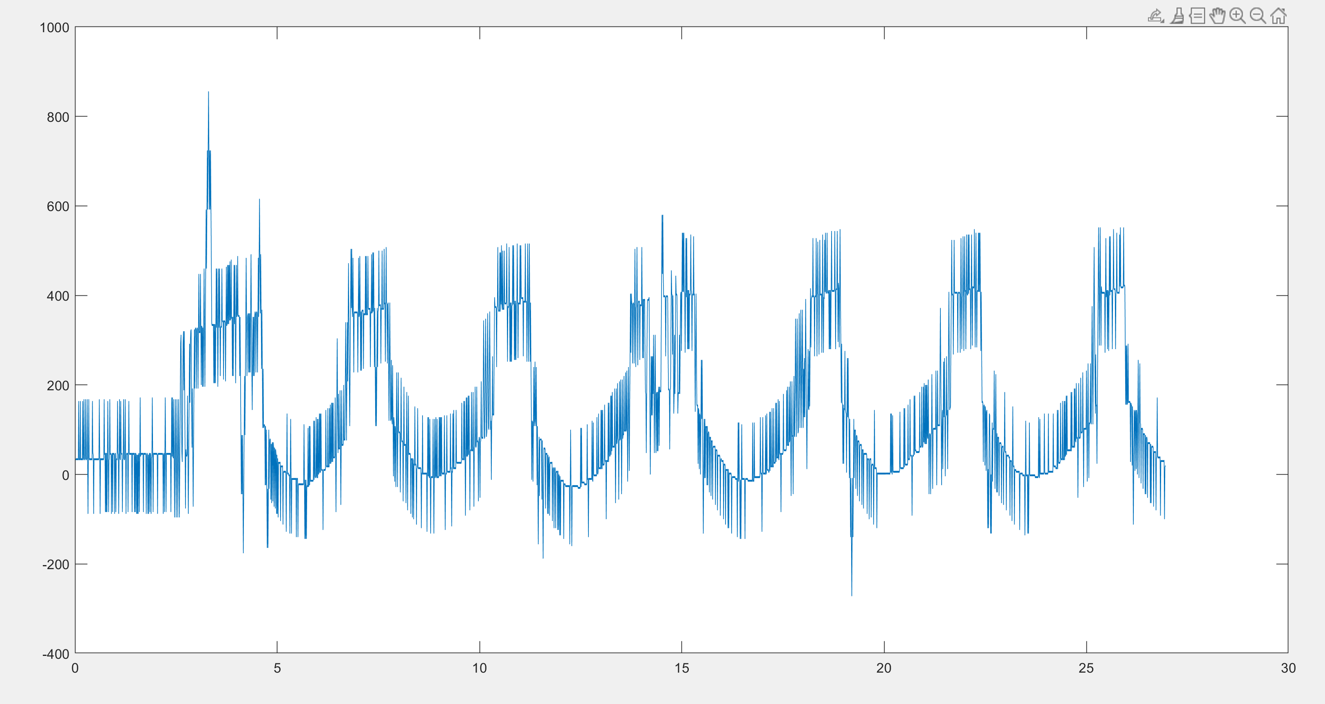
plots/10-1-10-deg.PNG
