Abyaneh/Control-of-Ball-Position-on-a-Horizontal-Rod/plots/10-1-10-position-1.PNG

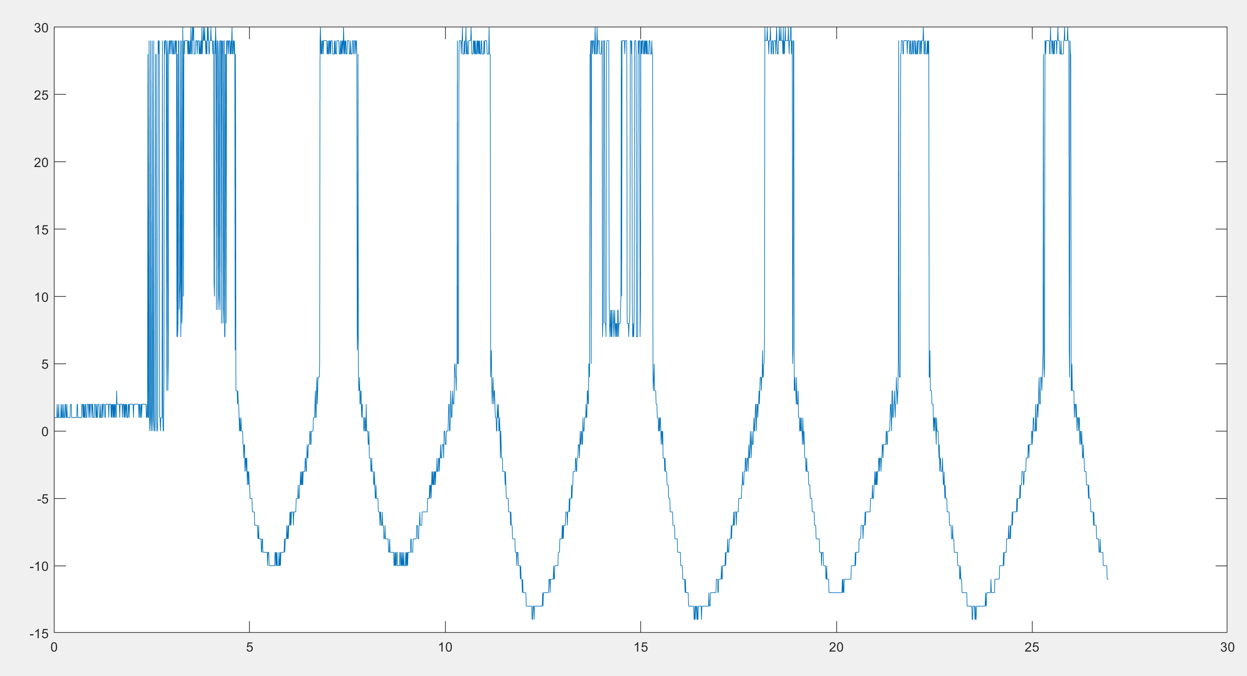
plots/10-1-10-position-1.PNG
