Abyaneh/Control-of-Ball-Position-on-a-Horizontal-Rod/Stm32Code/Core/Src/main.c

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
/* Includes ------------------------------------------------------------------*/
#include "main.h"

/* USER CODE BEGIN Includes */
#include <string.h>
#include <stdlib.h>
#include <stdio.h>
#include "pid.h"
/* USER CODE END Includes */

CAN_HandleTypeDef hcan1;

TIM_HandleTypeDef htim3;
TIM_HandleTypeDef htim8;

UART_HandleTypeDef huart2;

/* USER CODE BEGIN PV */
PID_TypeDef TPID;
double p = 8; //kp
double i = 1;  //ki
double d = 11; //kd
double PIDOut = 0;
double setposition = 0;
double actualDistancedouble = 0;

uint32_t IC_Val11 = 0;
uint32_t IC_Val21 = 0;
uint32_t Difference1 = 0;
uint8_t Is_First_Captured1 = 0;
uint32_t Distance1  = 0;

uint32_t IC_Val12 = 0;
uint32_t IC_Val22 = 0;
uint32_t Difference2 = 0;
uint8_t Is_First_Captured2 = 0;
uint32_t Distance2  = 0;

int32_t actualDistance = 0; //from center

uint8_t recvd_data=0x0; // receive buffer for UART
uint8_t data_buffer[100]; // data buffer for UART
uint8_t uartsendbuffer[100];
uint32_t countuart=0; // count how many bytes are received from UART

int32_t actualposition = 0; //actual position
int32_t destposition = 0; //destination position
uint8_t pulsestatus = 0; //pulse status

double actualpositiondouble = 0;
int32_t actualpositionforsend = 0;

int size_len;
/* USER CODE END PV */

void SystemClock_Config(void);
static void MX_GPIO_Init(void);
static void MX_CAN1_Init(void);
static void MX_TIM3_Init(void);
static void MX_USART2_UART_Init(void);
static void MX_TIM8_Init(void);
/* USER CODE BEGIN PFP */

void moveto(int32_t degree){ //move motor to target position example:123.45
	if(degree>-4500){
		if(degree<4500){
			destposition = -(degree*25)/100;
		}
	}
}

void delay (uint16_t time)
{
	__HAL_TIM_SET_COUNTER(&htim8, 0);
	while (__HAL_TIM_GET_COUNTER (&htim8) < time);
}

void SR05_Read1 (void){
	HAL_GPIO_WritePin(trig1_GPIO_Port, trig1_Pin, GPIO_PIN_SET);  // pull the TRIG pin HIGH
	delay(10);
	HAL_GPIO_WritePin(trig1_GPIO_Port, trig1_Pin, GPIO_PIN_RESET);  // pull the TRIG pin low
	__HAL_TIM_ENABLE_IT(&htim8, TIM_IT_CC1);
}

void SR05_Read2 (void){
	HAL_GPIO_WritePin(trig2_GPIO_Port, trig2_Pin, GPIO_PIN_SET);  // pull the TRIG pin HIGH
	delay(10);
	HAL_GPIO_WritePin(trig2_GPIO_Port, trig2_Pin, GPIO_PIN_RESET);  // pull the TRIG pin low
	__HAL_TIM_ENABLE_IT(&htim8, TIM_IT_CC2);
}

/* USER CODE END PFP */

/**
  * @brief  The application entry point.
  * @retval int
  */
int main(void)
{
  /* MCU Configuration--------------------------------------------------------*/

  /* Reset of all peripherals, Initializes the Flash interface and the Systick. */
  HAL_Init();

  /* Configure the system clock */
  SystemClock_Config();

  /* Initialize all configured peripherals */
  MX_GPIO_Init();
  MX_CAN1_Init();
  MX_TIM3_Init();
  MX_USART2_UART_Init();
  MX_TIM8_Init();
  /* USER CODE BEGIN 2 */
  HAL_TIM_Base_Start_IT(&htim3);
  HAL_UART_Receive_IT(&huart2,&recvd_data,1); //receive data from data buffer interrupt mode

  HAL_TIM_IC_Start_IT(&htim8, TIM_CHANNEL_1);
  HAL_TIM_IC_Start_IT(&htim8, TIM_CHANNEL_2);


  PID(&TPID, &actualDistancedouble, &PIDOut, &setposition, p, i, d, _PID_P_ON_E, _PID_CD_DIRECT);
  PID_SetMode(&TPID, _PID_MODE_AUTOMATIC);
  PID_SetSampleTime(&TPID, 10);
  PID_SetOutputLimits(&TPID, -3000, 3000);

  /* USER CODE END 2 */

  /* Infinite loop */
  /* USER CODE BEGIN WHILE */
  while (1)
  {
	  //SR05_Read1();
	  SR05_Read2();
	  Distance1 = Distance1;
	  Distance2 = Distance2;
	  actualDistance = -(24-Distance2);
	  actualDistancedouble = actualDistance;
	  HAL_Delay(10);
	  PID_Compute(&TPID);
	  moveto(PIDOut);
	  actualpositionforsend = (actualposition*100)/25;
	  size_len = sprintf(uartsendbuffer, "%d,",actualDistance);
	  HAL_UART_Transmit(&huart2,uartsendbuffer,size_len ,HAL_MAX_DELAY);
	  size_len = sprintf(uartsendbuffer, "%d\r\n",actualpositionforsend);
	  HAL_UART_Transmit(&huart2,uartsendbuffer,size_len ,HAL_MAX_DELAY);
	  //sprintf(uartsendbuffer, "%d\r\n",PIDOut);
	  //HAL_UART_Transmit(&huart2,uartsendbuffer,sizeof(uartsendbuffer),HAL_MAX_DELAY);
    /* USER CODE END WHILE */

    /* USER CODE BEGIN 3 */
  }
  /* USER CODE END 3 */
}

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
/* USER CODE BEGIN 4 */

void HAL_UART_RxCpltCallback(UART_HandleTypeDef *huart)
{
	 if(recvd_data == '\r' || recvd_data == 'p'  || recvd_data == 'i' || recvd_data == 'd' || recvd_data == 'm') //when enter is pressed go to this condition
	 {
		 data_buffer[countuart++]='\r';
		 //HAL_UART_Transmit(huart,data_buffer,countuart,HAL_MAX_DELAY); //transmit the full sentence again

		 //moveto(atol(data_buffer));
		 //sprintf(uartsendbuffer, "%d\r\n",Distance1);
		 int32_t temp = atol(data_buffer);
		 if(recvd_data=='p')p = temp;
		 if(recvd_data=='i')i = temp;
		 if(recvd_data=='d')d = temp;
		 if(recvd_data=='m')setposition = temp;

		 PID(&TPID, &actualDistancedouble, &PIDOut, &setposition, p, i, d, _PID_P_ON_E, _PID_CD_DIRECT);
		 PID_SetMode(&TPID, _PID_MODE_AUTOMATIC);
		 PID_SetSampleTime(&TPID, 10);
		 PID_SetOutputLimits(&TPID, -3000, 3000);
		 //HAL_UART_Transmit(huart,data_buffer,10,HAL_MAX_DELAY);
		 //sprintf(data_buffer, "%d\r\n",destposition);
		 //HAL_UART_Transmit(huart,data_buffer,countuart,HAL_MAX_DELAY);

		 memset(data_buffer, 0, countuart); // enpty the data buffer
		 countuart=0;
	 }
	 else
	 {
		 data_buffer[countuart++] = recvd_data; // every time when interrput is happen, received 1 byte of data
	 }
	 HAL_UART_Receive_IT(&huart2,&recvd_data,1); //start next data receive interrupt
}

void HAL_TIM_PeriodElapsedCallback(TIM_HandleTypeDef *htim)
{
	if(htim==&htim3)
	{
		if(pulsestatus==1)
		{
			HAL_GPIO_WritePin(Pulse_GPIO_Port, Pulse_Pin, GPIO_PIN_RESET);
			pulsestatus = 0;
		}
		else
		{
			if(destposition>=actualposition){
				HAL_GPIO_WritePin(Dir_GPIO_Port, Dir_Pin, GPIO_PIN_RESET);
				actualposition++;
				HAL_GPIO_WritePin(Pulse_GPIO_Port, Pulse_Pin, GPIO_PIN_SET);
				pulsestatus = 1;
			}
			else if(destposition<actualposition){
				HAL_GPIO_WritePin(Dir_GPIO_Port, Dir_Pin, GPIO_PIN_SET);
				actualposition--;
				HAL_GPIO_WritePin(Pulse_GPIO_Port, Pulse_Pin, GPIO_PIN_SET);
				pulsestatus = 1;
			}

		}
		HAL_GPIO_TogglePin(Pulse_GPIO_Port, Pulse_Pin);
	}
}

//SR05_Read
void input_capture1(void)
	{
		if (Is_First_Captured1==0)
		{
			IC_Val11 = HAL_TIM_ReadCapturedValue(&htim8, TIM_CHANNEL_1);
			Is_First_Captured1 = 1;

			__HAL_TIM_SET_CAPTUREPOLARITY(&htim8, TIM_CHANNEL_1, TIM_INPUTCHANNELPOLARITY_FALLING);
		}
		else if (Is_First_Captured1==1)
		{
			IC_Val21 = HAL_TIM_ReadCapturedValue(&htim8, TIM_CHANNEL_1);
			__HAL_TIM_SET_COUNTER(&htim8, 0);

			if (IC_Val21 > IC_Val11)
			{
				Difference1 = IC_Val21-IC_Val11;
				if(((Difference1*2)/100)<60) Distance1 = (Difference1*2)/100;
			}



			Is_First_Captured1 = 0;


			__HAL_TIM_SET_CAPTUREPOLARITY(&htim8, TIM_CHANNEL_1, TIM_INPUTCHANNELPOLARITY_RISING);
			__HAL_TIM_DISABLE_IT(&htim8, TIM_IT_CC1);
			}
}

void input_capture2(void)
	{
		if (Is_First_Captured2==0)
		{
			IC_Val12 = HAL_TIM_ReadCapturedValue(&htim8, TIM_CHANNEL_2);
			Is_First_Captured2 = 1;

			__HAL_TIM_SET_CAPTUREPOLARITY(&htim8, TIM_CHANNEL_2, TIM_INPUTCHANNELPOLARITY_FALLING);
		}
		else if (Is_First_Captured2==1)
		{
			IC_Val22 = HAL_TIM_ReadCapturedValue(&htim8, TIM_CHANNEL_2);
			__HAL_TIM_SET_COUNTER(&htim8, 0);

			if (IC_Val22 > IC_Val12)
			{
				Difference2 = IC_Val22-IC_Val12;
				if(((Difference2*2)/100)<60) Distance2 = (Difference2*2)/100;
			}

			Is_First_Captured2 = 0;


			__HAL_TIM_SET_CAPTUREPOLARITY(&htim8, TIM_CHANNEL_2, TIM_INPUTCHANNELPOLARITY_RISING);
			__HAL_TIM_DISABLE_IT(&htim8, TIM_IT_CC2);
			}
}

void HAL_TIM_IC_CaptureCallback(TIM_HandleTypeDef *htim)
{
	if (htim->Channel == HAL_TIM_ACTIVE_CHANNEL_1)
	{
		input_capture1();
	}
	if (htim->Channel == HAL_TIM_ACTIVE_CHANNEL_2)
	{
		input_capture2();
	}
}
/* USER CODE END 4 */
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
