Abyaneh/Control-of-Ball-Position-on-a-Horizontal-Rod/Stm32Code/Core/Inc/main.h

#define Pulse_Pin GPIO_PIN_2
#define Pulse_GPIO_Port GPIOE
#define Dir_Pin GPIO_PIN_3
#define Dir_GPIO_Port GPIOE
#define echo1_Pin GPIO_PIN_6
#define echo1_GPIO_Port GPIOC
#define echo2_Pin GPIO_PIN_7
#define echo2_GPIO_Port GPIOC
#define trig1_Pin GPIO_PIN_8
#define trig1_GPIO_Port GPIOC
#define trig2_Pin GPIO_PIN_9
#define trig2_GPIO_Port GPIOC
